enacuavlab/boards/Tawaki/hardware/Outils Montage/test_ gabarit.SLDASM

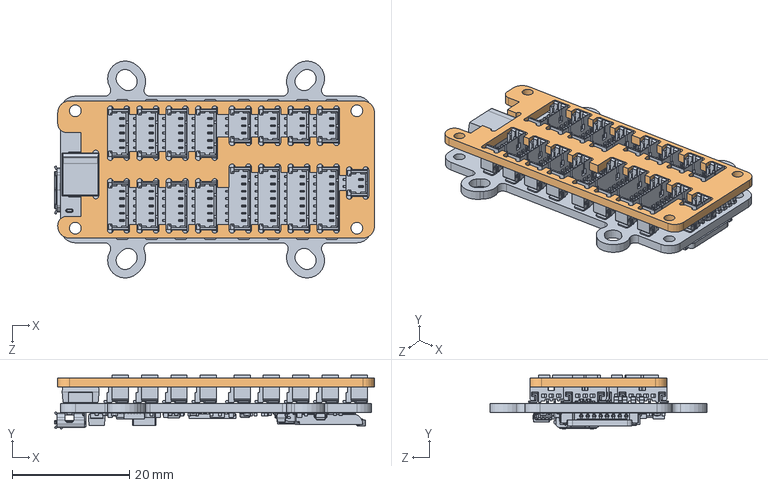
[picture p2: CAD file, 2021-02-25]
Tawaki/hardware/Outils Montage/test_ gabarit.SLDASM
54.5 x 9.16 x 37.0 mm
Tawaki_v100
gabarit_soudage_molex_v0
