enacuavlab/boards/Tawaki/hardware/Outils Montage/fab/gabarit_soudage_molex_v0.DXF

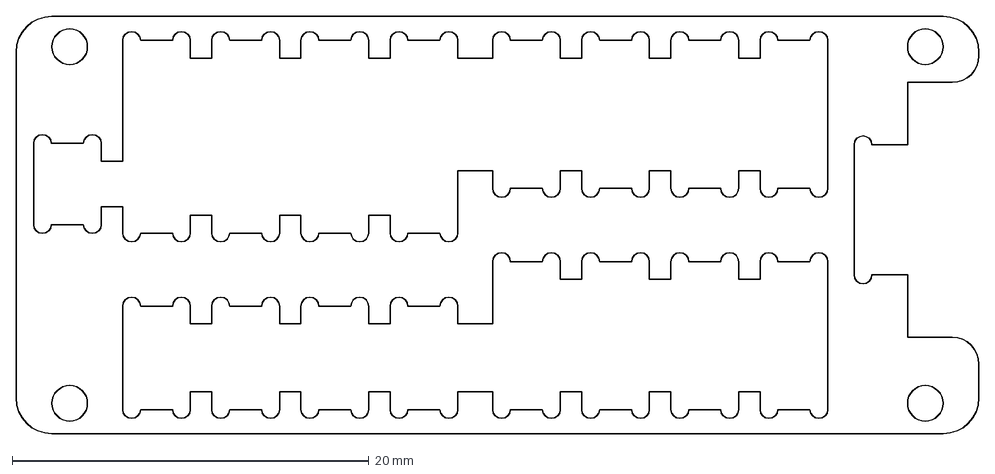
[picture p3: CAD file, 2021-02-25]
Tawaki/hardware/Outils Montage/fab/gabarit_soudage_molex_v0.DXF
54.0 x 23.4 mm
