enacuavlab/boards/Tawaki/hardware/Outils Montage/gabarit_soudage_molex_v0.SLDPRT

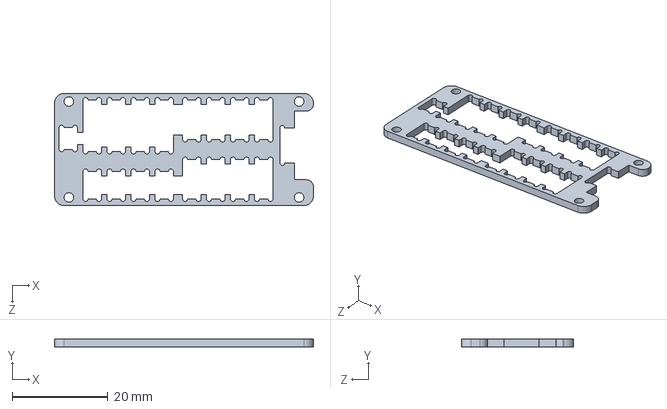
[picture p4: CAD file, 2021-02-25]
Tawaki/hardware/Outils Montage/gabarit_soudage_molex_v0.SLDPRT
54.0 x 1.60 x 23.4 mm
