enacuavlab/boards/Tawaki/hardware/Tawaki_v110_implantation bottom.pdf

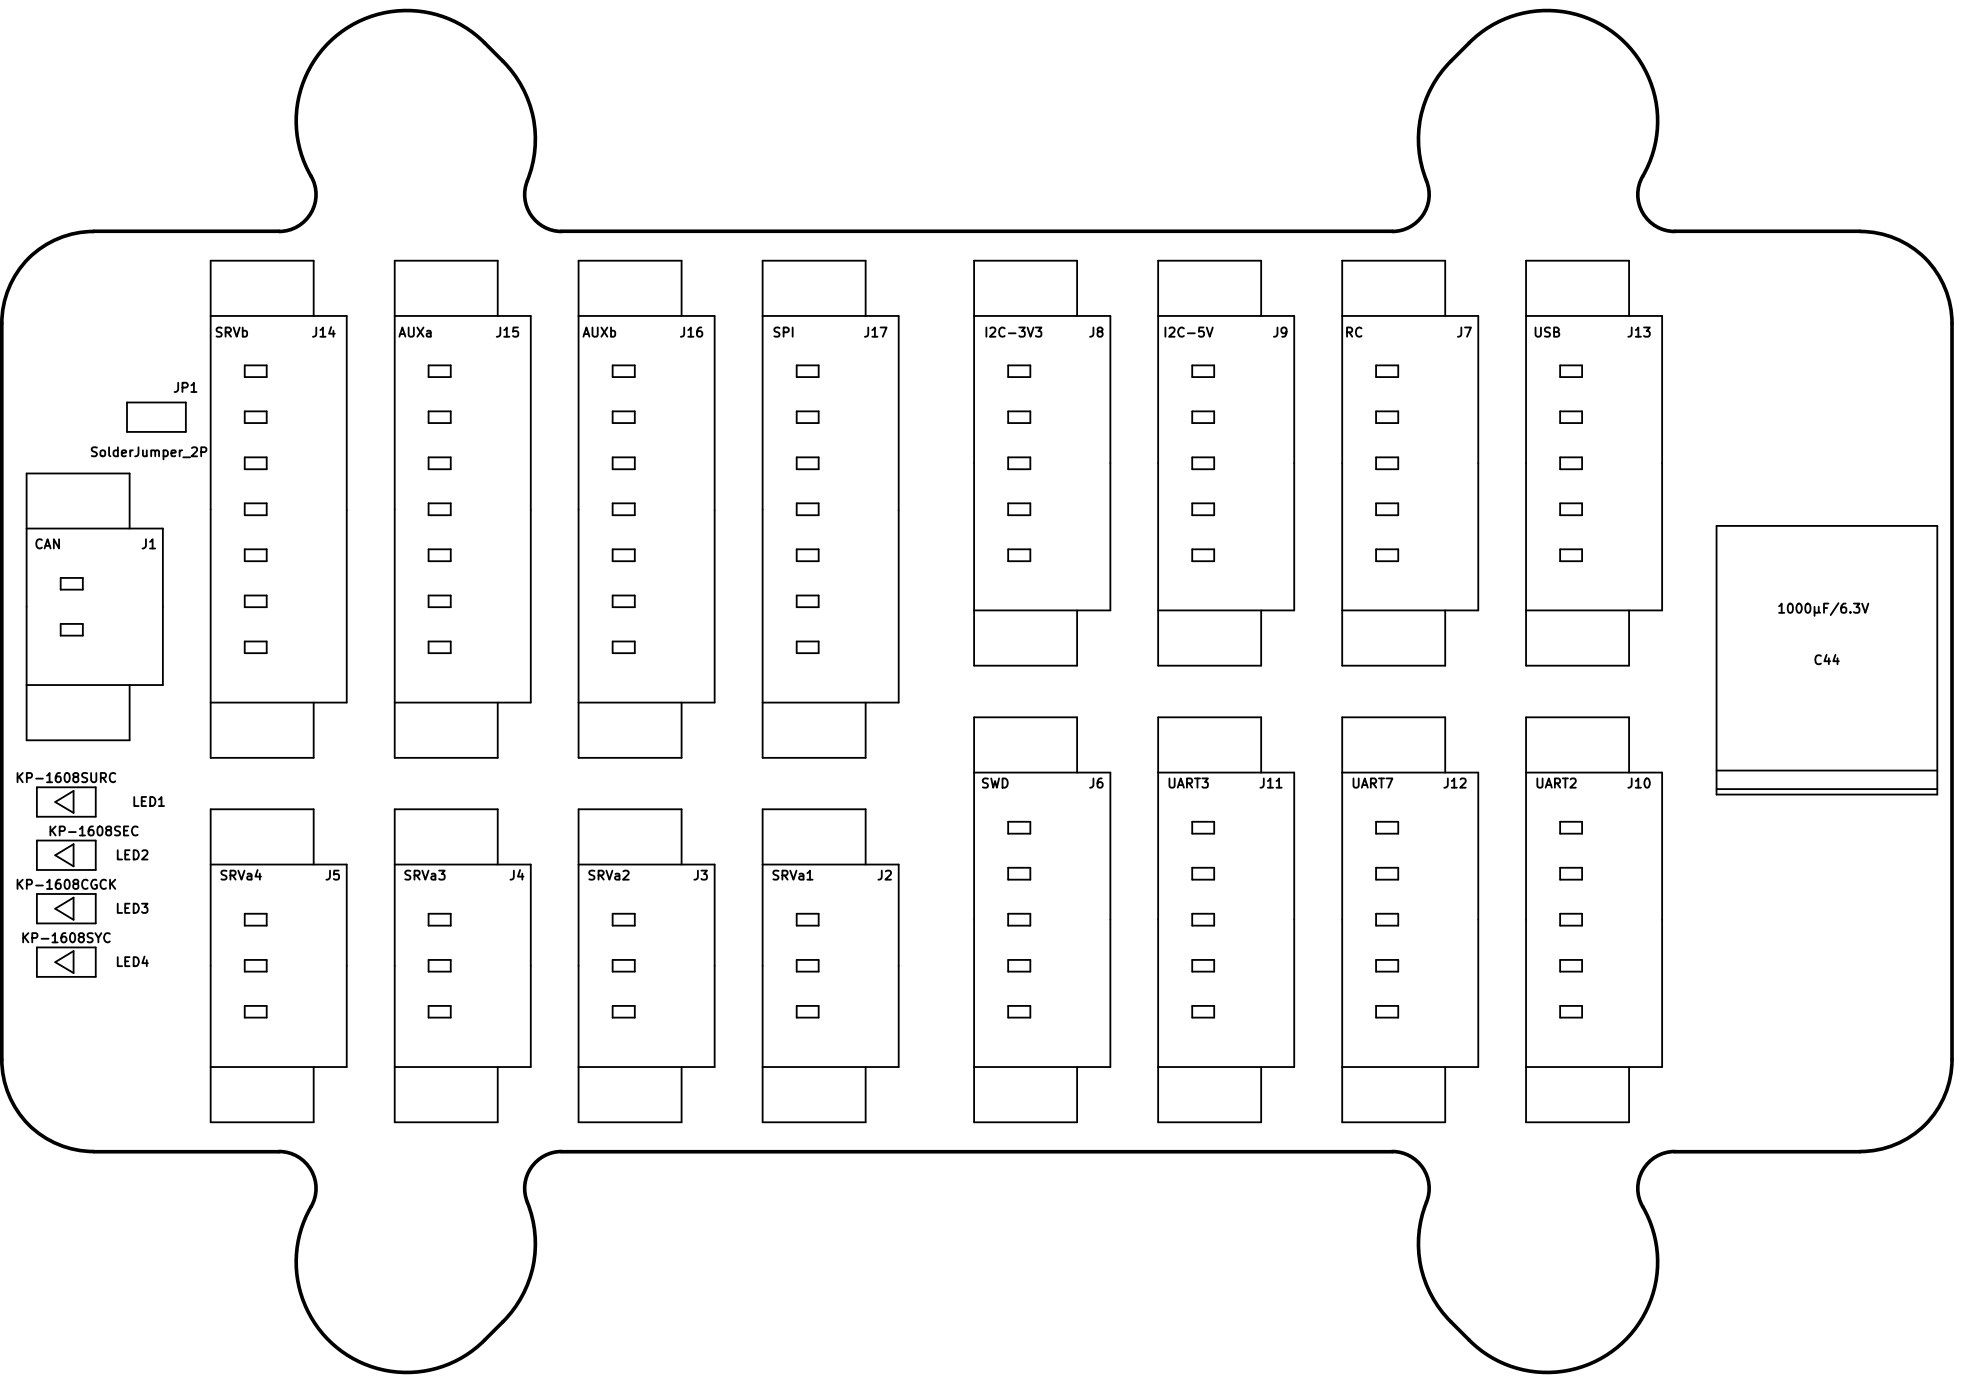
[picture p5: page 1]
