enacuavlab/boards/Tawaki/hardware/Tawaki_v110.kicad_pcb

## KiCad design Tawaki/hardware/Tawaki_v110.kicad_pcb (2021-02-25)

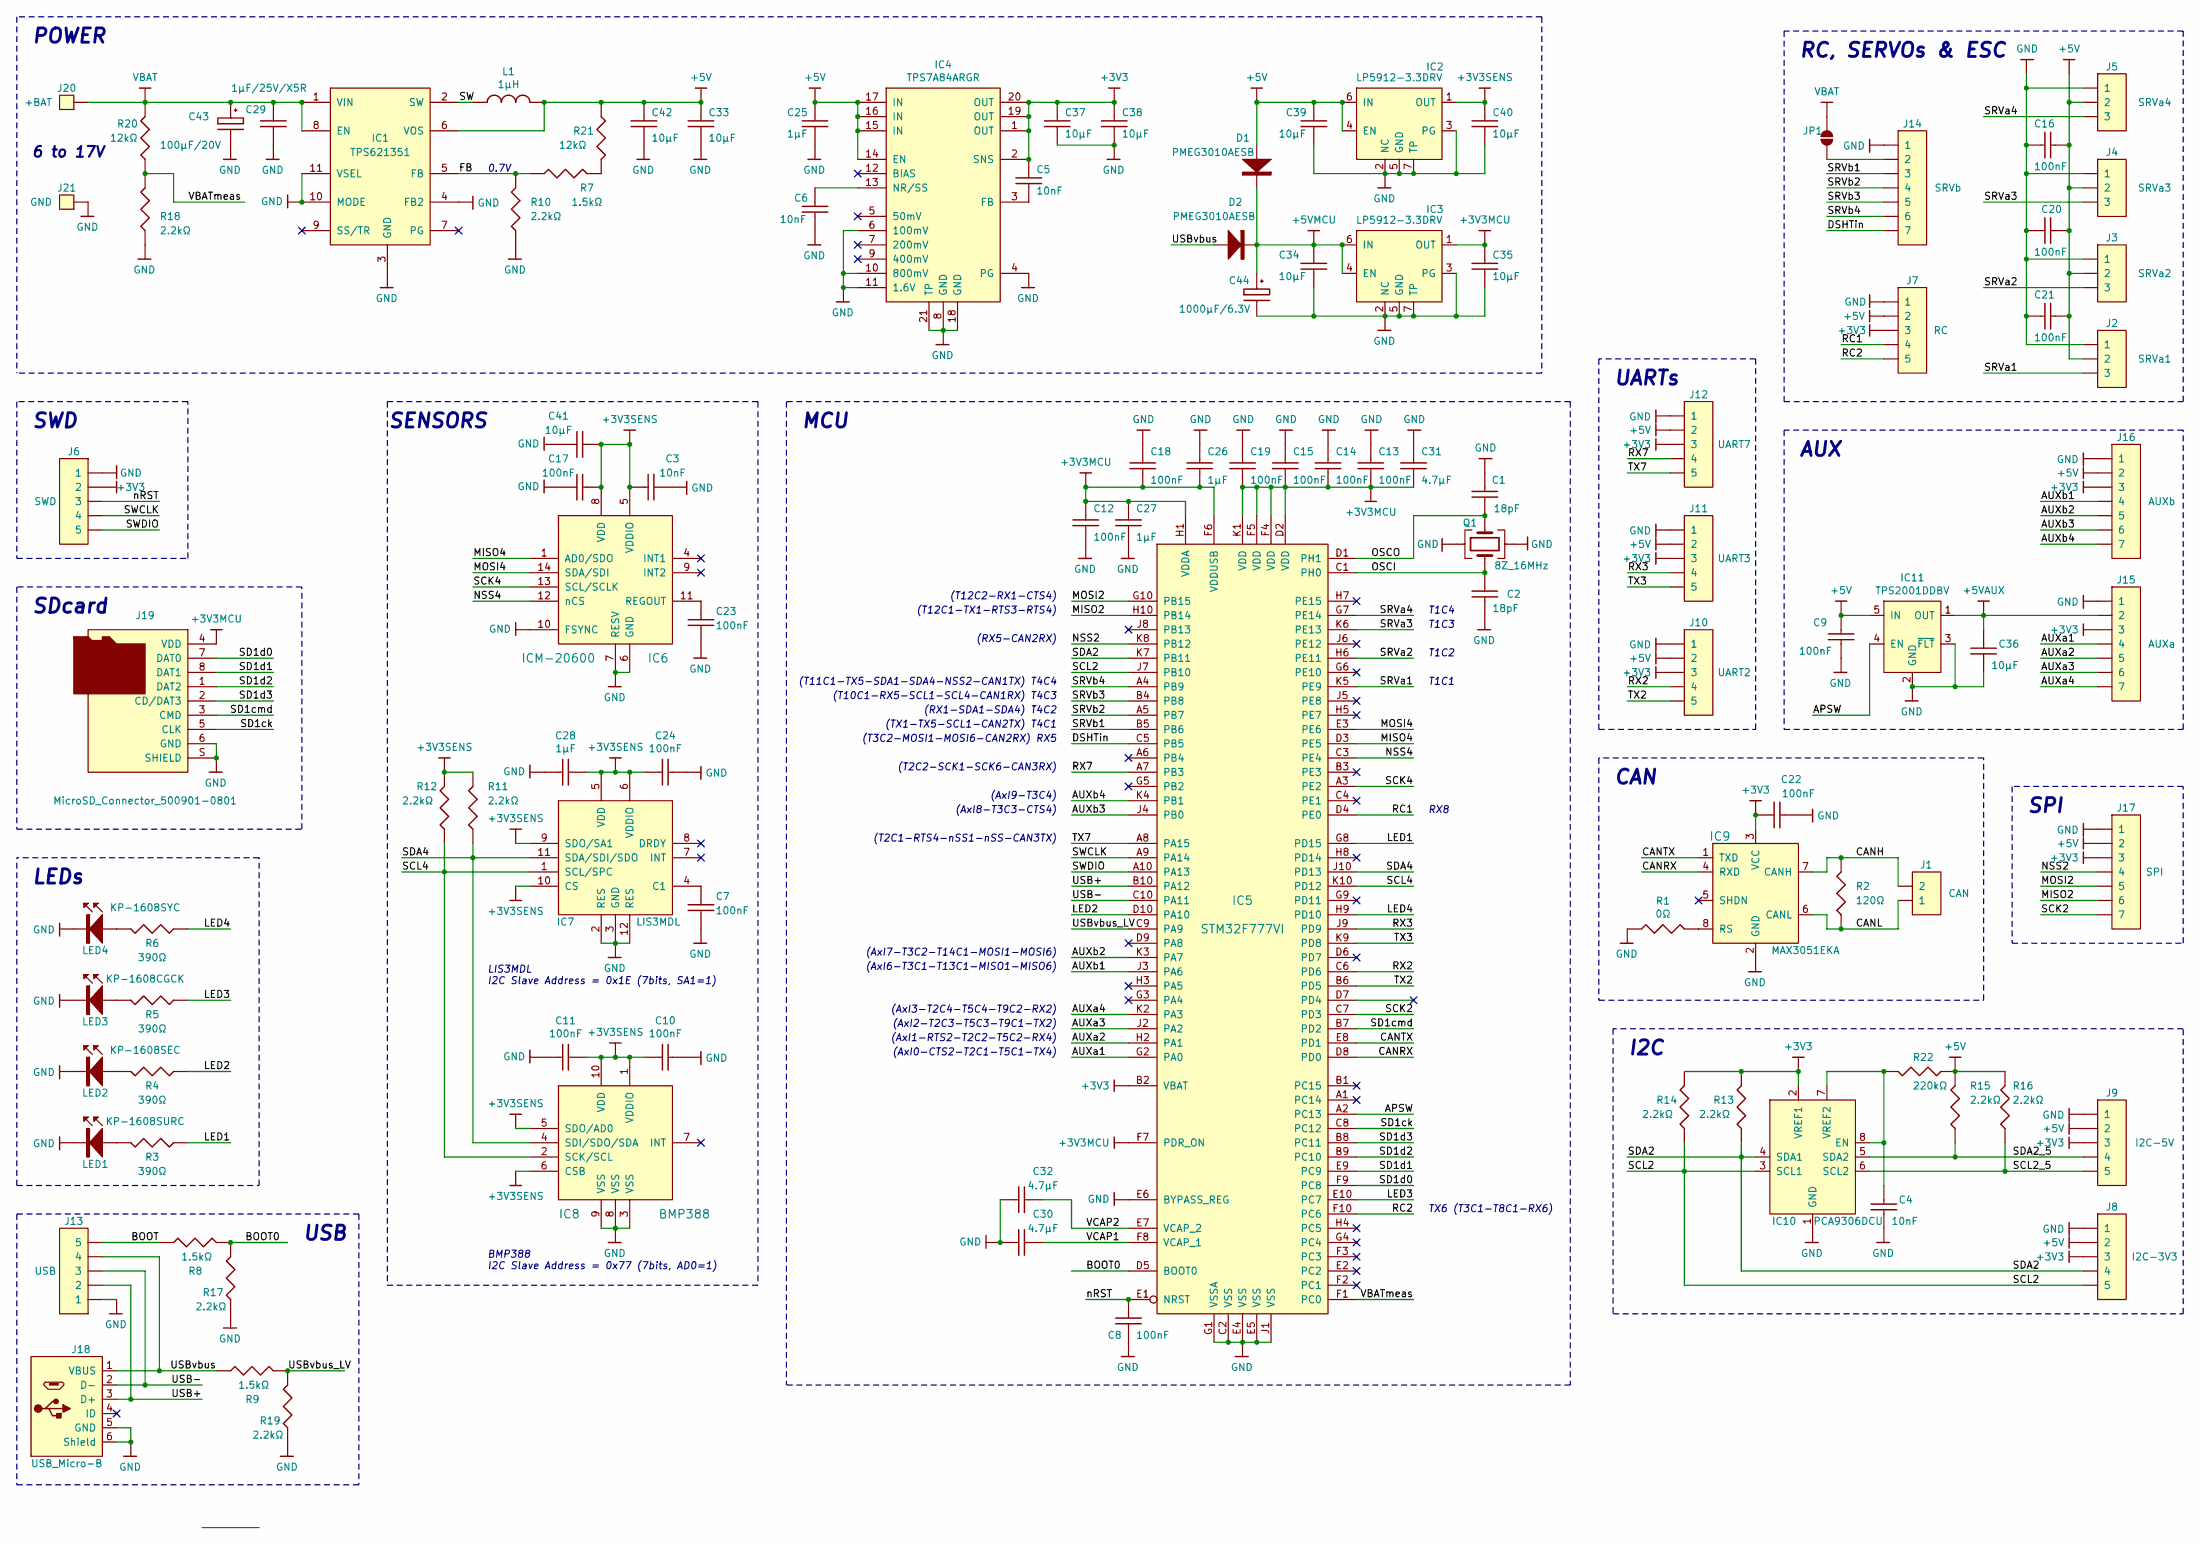
[picture p6: schematic Tawaki_v110.sch, Tawaki Autopilot v1.10]

Parts:
C1, C2: 18pF; C_0402
C3, C4, C5, C6: 10nF; C_0402
C7, C8, C9, C10, C11, C12, C13, C14, C15, C16, C17, C18, C19, C20, C21, C22, C23, C24: 100nF; C_0402
C25, C26, C27, C28: 1µF; C_0402
C29: 1µF/25V/X5R; C_0603
C30, C31, C32: 4.7µF; C_0402
C33, C34, C35, C36, C37, C38, C39, C40, C41, C42: 10µF; C_0603
C43: 100µF/20V; EIA_7343-31
C44: 1000µF/6.3V; EIA_7360-38
D1, D2: PMEG3010AESB
IC1: TPS621351
IC2, IC3: LP5912-3.3DRV; LP5912DRV
IC4: TPS7A84ARGR
IC5: STM32F777VI
IC6: ICM-20600
IC7: LIS3MDL
IC8: BMP388
IC9: MAX3051EKA
IC10: PCA9306DCU
IC11: TPS2001DDBV
J1: CAN; PicoBlade_53398-0271
J2: SRVa1; PicoBlade_53398-0371
J3: SRVa2; PicoBlade_53398-0371
J4: SRVa3; PicoBlade_53398-0371
J5: SRVa4; PicoBlade_53398-0371
J6: SWD; PicoBlade_53398-0571
J7: RC; PicoBlade_53398-0571
J8: I2C-3V3; PicoBlade_53398-0571
J9: I2C-5V; PicoBlade_53398-0571
J10: UART2; PicoBlade_53398-0571
J11: UART3; PicoBlade_53398-0571
J12: UART7; PicoBlade_53398-0571
J13: USB; PicoBlade_53398-0571
J14: SRVb; PicoBlade_53398-0771
J15: AUXa; PicoBlade_53398-0771
J16: AUXb; PicoBlade_53398-0771
J17: SPI; PicoBlade_53398-0771
J18: USB_Micro-B; USB_Micro-B_Molex_105017-0001
J19: MicroSD_Connector_500901-0801; MicroSD_500901-0801
J20: +BAT; SquareWirePad_SMD_2x4mm
J21: GND; SquareWirePad_SMD_2x4mm
JP1: SolderJumper_2P; SolderJumper_2P_TrianglePads_0603
L1: 1µH; XFL4020
LED1: KP-1608SURC
LED2: KP-1608SEC
LED3: KP-1608CGCK
LED4: KP-1608SYC
Q1: 8Z_16MHz; Crystal_8Z
R1: 0Ω; R_0402
R2: 120Ω; R_0402
R3, R4, R5, R6: 390Ω; R_0402
R7, R8, R9: 1.5kΩ; R_0402
R10, R11, R12, R13, R14, R15, R16, R17, R18, R19: 2.2kΩ; R_0402
R20, R21: 12kΩ; R_0402
R22: 220kΩ; R_0402

Connections:
+3V3: C5.1, C22.2, C37.1, C38.1, IC4.1 (OUT), IC4.2 (SNS), IC4.19 (OUT), IC4.20 (OUT), IC5.B2 (VBAT), IC9.3 (VCC), IC10.2 (VREF1), J6.2, J7.3, J8.3, J9.3, J10.3, J11.3, J12.3, J15.3, J16.3, J17.3, R13.1, R14.1
+3V3MCU: C12.1, C13.2, C14.2, C15.2, C18.2, C19.2, C26.2, C27.1, C31.2, C35.1, IC3.1 (OUT), IC5.D2 (VDD), IC5.F4 (VDD), IC5.F5 (VDD), IC5.F6 (VDDUSB), IC5.F7 (PDR_ON), IC5.H1 (VDDA), IC5.K1 (VDD), J19.4 (VDD)
+3V3SENS: C3.2, C10.2, C11.1, C17.1, C24.2, C28.1, C40.1, C41.1, IC2.1 (OUT), IC6.5 (VDDIO), IC6.8 (VDD), IC7.5 (VDD), IC7.6 (VDDIO), IC7.9 (SDO/SA1), IC7.10 (CS), IC8.1 (VDDIO), IC8.5 (SDO/AD0), IC8.6 (CSB), IC8.10 (VDD), R11.1, R12.1
+5V: C9.1, C16.1, C20.1, C21.1, C25.1, C33.1, C39.1, C42.1, D1.2 (A), IC1.6 (VOS), IC2.4 (EN), IC2.6 (IN), IC4.14 (EN), IC4.15 (IN), IC4.16 (IN), IC4.17 (IN), IC11.5 (IN), J2.2, J3.2, J4.2, J5.2, J7.2, J8.2, J9.2, J10.2, J11.2, J12.2, J16.2, J17.2, L1.2, R15.1, R16.1, R21.2, R22.1
+5VAUX: C36.1, IC11.1 (OUT), J15.2
+5VMCU: C34.1, C44.1, D1.1 (K), D2.1 (K), IC3.4 (EN), IC3.6 (IN)
/APSW: IC5.A2 (PC13), IC11.4 (EN)
/AUXa1: IC5.G2 (PA0), J15.4
/AUXa2: IC5.H2 (PA1), J15.5
/AUXa3: IC5.J2 (PA2), J15.6
/AUXa4: IC5.K2 (PA3), J15.7
/AUXb1: IC5.J3 (PA6), J16.4
/AUXb2: IC5.K3 (PA7), J16.5
/AUXb3: IC5.J4 (PB0), J16.6
/AUXb4: IC5.K4 (PB1), J16.7
/BOOT: J13.5, R8.2
/BOOT0: IC5.D5 (BOOT0), R8.1, R17.1
/CANH: IC9.7 (CANH), J1.2, R2.1
/CANL: IC9.6 (CANL), J1.1, R2.2
/CANRX: IC5.D8 (PD0), IC9.4 (RXD)
/CANTX: IC5.E8 (PD1), IC9.1 (TXD)
/DSHTin: IC5.C5 (PB5), J14.7
/FB: IC1.5 (FB), R7.2, R10.1
/LED1: IC5.G8 (PD15), R3.1
/LED2: IC5.D10 (PA10), R4.1
/LED3: IC5.E10 (PC7), R5.1
/LED4: IC5.H9 (PD10), R6.1
/MISO2: IC5.H10 (PB14), J17.6
/MISO4: IC5.D3 (PE5), IC6.1 (AD0/SDO)
/MOSI2: IC5.G10 (PB15), J17.5
/MOSI4: IC5.E3 (PE6), IC6.14 (SDA/SDI)
/NSS2: IC5.K8 (PB12), J17.4
/NSS4: IC5.C3 (PE4), IC6.12 (nCS)
/OSCI: C2.2, IC5.C1 (PH0), Q1.3
/OSCO: C1.2, IC5.D1 (PH1), Q1.1
/RC1: IC5.D4 (PE0), J7.4
/RC2: IC5.F10 (PC6), J7.5
/RX2: IC5.C6 (PD6), J10.4
/RX3: IC5.J9 (PD9), J11.4
/RX7: IC5.A7 (PB3), J12.4
/SCK2: IC5.C7 (PD3), J17.7
/SCK4: IC5.A3 (PE2), IC6.13 (SCL/SCLK)
/SCL2: IC5.J7 (PB10), IC10.3 (SCL1), J8.5, R14.2
/SCL2_5: IC10.6 (SCL2), J9.5, R16.2
/SCL4: IC5.K10 (PD12), IC7.1 (SCL/SPC), IC8.2 (SCK/SCL), R12.2
/SD1ck: IC5.C8 (PC12), J19.5 (CLK)
/SD1cmd: IC5.B7 (PD2), J19.3 (CMD)
/SD1d0: IC5.F9 (PC8), J19.7 (DAT0)
/SD1d1: IC5.E9 (PC9), J19.8 (DAT1)
/SD1d2: IC5.B9 (PC10), J19.1 (DAT2)
/SD1d3: IC5.B8 (PC11), J19.2 (CD/DAT3)
/SDA2: IC5.K7 (PB11), IC10.4 (SDA1), J8.4, R13.2
/SDA2_5: IC10.5 (SDA2), J9.4, R15.2
/SDA4: IC5.J10 (PD13), IC7.11 (SDA/SDI/SDO), IC8.4 (SDI/SDO/SDA), R11.2
/SRVa1: IC5.K5 (PE9), J2.3
/SRVa2: IC5.H6 (PE11), J3.3
/SRVa3: IC5.K6 (PE13), J4.3
/SRVa4: IC5.G7 (PE14), J5.3
/SRVb1: IC5.B5 (PB6), J14.3
/SRVb2: IC5.A5 (PB7), J14.4
/SRVb3: IC5.B4 (PB8), J14.5
/SRVb4: IC5.A4 (PB9), J14.6
/SW: IC1.2 (SW), L1.1
/SWCLK: IC5.A9 (PA14), J6.4
/SWDIO: IC5.A10 (PA13), J6.5
/TX2: IC5.B6 (PD5), J10.5
/TX3: IC5.K9 (PD8), J11.5
/TX7: IC5.A8 (PA15), J12.5
/USB+: IC5.B10 (PA12), J13.2, J18.3 (D+)
/USB-: IC5.C10 (PA11), J13.3, J18.2 (D-)
/USBvbus: D2.2 (A), J13.4, J18.1 (VBUS), R9.2
/USBvbus_LV: IC5.C9 (PA9), R9.1, R19.1
/VBATmeas: IC5.F1 (PC0), R18.1, R20.2
/VCAP1: C30.1, IC5.F8 (VCAP_1)
/VCAP2: C32.1, IC5.E7 (VCAP_2)
/nRST: C8.1, IC5.E1 (NRST), J6.3
GND: C1.1, C2.1, C3.1, C4.2, C6.2, C7.2, C8.2, C9.2, C10.1, C11.2, C12.2, C13.1, C14.1, C15.1, C16.2, C17.2, C18.1, C19.1, C20.2, C21.2, C22.1, C23.2, C24.1, C25.2, C26.1, C27.2, C28.2, C29.2, C30.2, C31.1, C32.2, C33.2, C34.2, C35.2, C36.2, C37.2, C38.2, C39.2, C40.2, C41.2, C42.2, C43.2, C44.2, IC1.3 (GND), IC1.4 (FB2), IC1.10 (MODE), IC1.11 (VSEL), IC2.2 (NC), IC2.3 (PG), IC2.5 (GND), IC2.7 (TP), IC3.2 (NC), IC3.3 (PG), IC3.5 (GND), IC3.7 (TP), IC4.4 (PG), IC4.6 (100mV), IC4.8 (GND), IC4.10 (800mV), IC4.11 (1.6V), IC4.18 (GND), IC4.21 (TP), IC5.C2 (VSS), IC5.E4 (VSS), IC5.E5 (VSS), IC5.E6 (BYPASS_REG), IC5.G1 (VSSA), IC5.J1 (VSS), IC6.6 (GND), IC6.7 (RESV), IC6.10 (FSYNC), IC7.2 (RES), IC7.3 (GND), IC7.12 (RES), IC8.3 (VSS), IC8.8 (VSS), IC8.9 (VSS), IC9.2 (GND), IC10.1 (GND), IC11.2 (GND), IC11.3 (~FLT), J2.1, J3.1, J4.1, J5.1, J6.1, J7.1, J8.1, J9.1, J10.1, J11.1, J12.1, J13.1, J14.1, J15.1, J16.1, J17.1, J18.5 (GND), J18.6 (Shield), J19.6 (GND), J19.S (SHIELD), J21.1, LED1.1 (K), LED2.1 (K), LED3.1 (K), LED4.1 (K), Q1.2, Q1.4, R1.2, R10.2, R17.2, R18.2, R19.2
unnamed: C4.1, IC10.7 (VREF2), IC10.8 (EN), R22.2
unnamed: C5.2, IC4.3 (FB)
unnamed: C6.1, IC4.13 (NR/SS)
unnamed: C7.1, IC7.4 (C1)
unnamed: C23.1, IC6.11 (REGOUT)
unnamed: IC9.8 (RS), R1.1
unnamed: J14.2, JP1.2 (B)
unnamed: LED1.2 (A), R3.2
unnamed: LED2.2 (A), R4.2
unnamed: LED3.2 (A), R5.2
unnamed: LED4.2 (A), R6.2
unnamed: R7.1, R21.1
VBAT: C29.1, C43.1, IC1.1 (VIN), IC1.8 (EN), J20.1, JP1.1 (A), R20.1

Notes on the sheet:
0.7V
6 to 17V
I2C
CAN
RC, SERVOs & ESC
MCU
UARTs
SPI
USB
AUX
SENSORS
LIS3MDL I2C Slave Address = 0x1E (7bits, SA1=1)
BMP388 I2C Slave Address = 0x77 (7bits, AD0=1)
POWER
RX8
TX6 (T3C1-T8C1-RX6)
(AxI0-CTS2-T2C1-T5C1-TX4)
(AxI1-RTS2-T2C2-T5C2-RX4)
(AxI6-T3C1-T13C1-MISO1-MISO6)
(AxI2-T2C3-T5C3-T9C1-TX2)
(AxI3-T2C4-T5C4-T9C2-RX2)
(AxI7-T3C2-T14C1-MOSI1-MOSI6)
(AxI8-T3C3-CTS4)
(AxI9-T3C4)
T1C1
T1C2
T1C3
T1C4
(TX1-TX5-SCL1-CAN2TX) T4C1
(RX1-SDA1-SDA4) T4C2
(T10C1-RX5-SCL1-SCL4-CAN1RX) T4C3
(T11C1-TX5-SDA1-SDA4-NSS2-CAN1TX) T4C4
(T3C2-MOSI1-MOSI6-CAN2RX) RX5
(T12C2-RX1-CTS4)
(T12C1-TX1-RTS3-RTS4)
(T2C2-SCK1-SCK6-CAN3RX)
(T2C1-RTS4-nSS1-nSS-CAN3TX)
(RX5-CAN2RX)
SDcard
LEDs
SWD

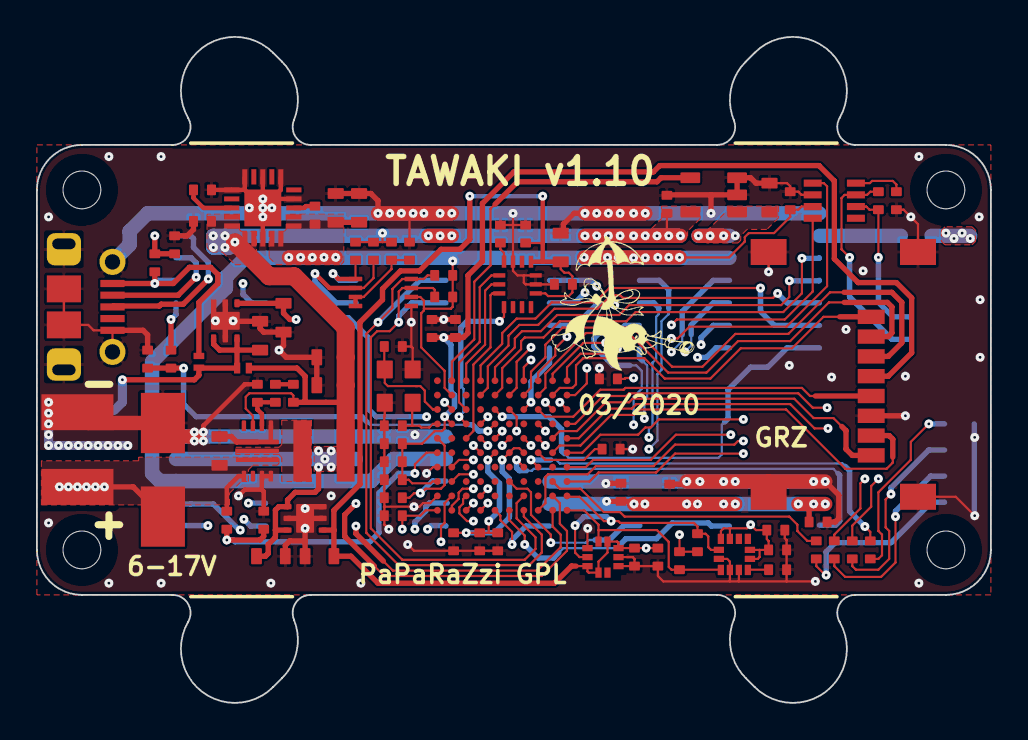
[picture p7: board Tawaki_v110.kicad_pcb from above]

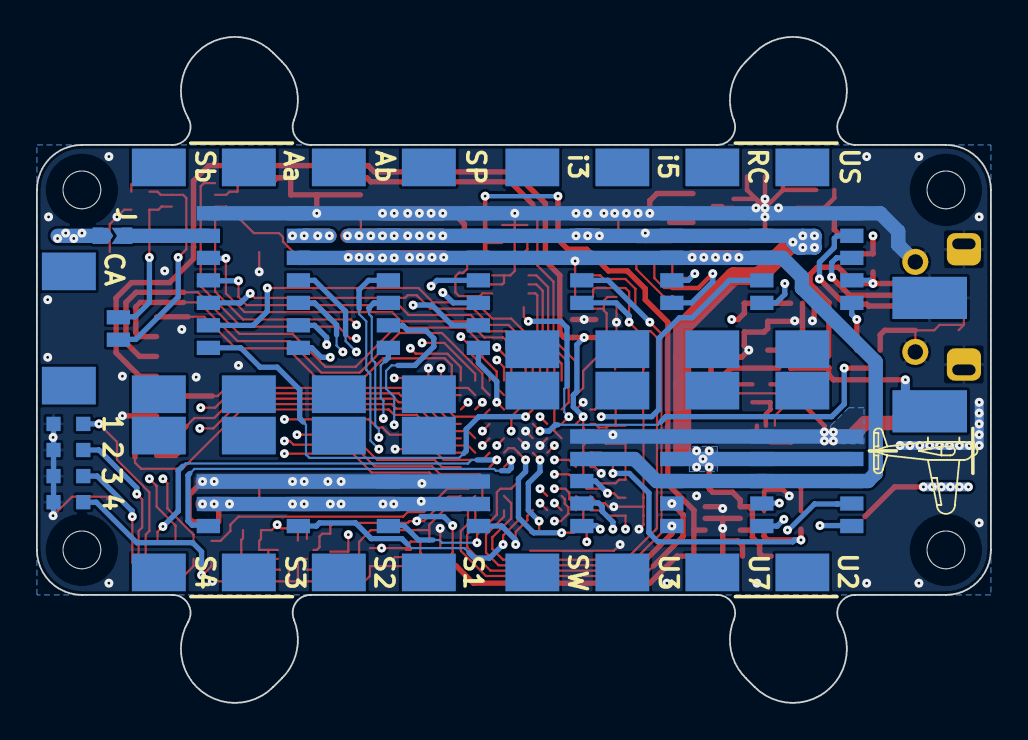
[picture p8: board Tawaki_v110.kicad_pcb from below]

Board: 4 copper layers, 53.0 x 37.0 mm, 107 parts (23 on the bottom side), 90 nets.
