enacuavlab/boards/Chimera/chibios/cfg/board.h

/*
    ChibiOS - Copyright (C) 2006..2015 Giovanni Di Sirio

    Licensed under the Apache License, Version 2.0 (the "License");
    you may not use this file except in compliance with the License.
    You may obtain a copy of the License at

        http://www.apache.org/licenses/LICENSE-2.0

    Unless required by applicable law or agreed to in writing, software
    distributed under the License is distributed on an "AS IS" BASIS,
    WITHOUT WARRANTIES OR CONDITIONS OF ANY KIND, either express or implied.
    See the License for the specific language governing permissions and
    limitations under the License.
*/

#pragma once

/*
 * Board identifier.
 */
#define BOARD_CHIMERA
#define BOARD_NAME                  "Chimera Autopilot"

/*
 * Board oscillators-related settings.
 */
#if !defined(STM32_LSECLK)
#define STM32_LSECLK                32768U
#endif

#define STM32_LSEDRV                (3U << 3U)

#if !defined(STM32_HSECLK)
#define STM32_HSECLK                16000000U
#endif

/*
 * Board voltages.
 * Required for performance limits calculation.
 */
#define STM32_VDD                   300U

/*
 * MCU type as defined in the ST header.
 */
#define STM32F767xx

/*
 * IO pins assignments.
 */
#define	PA00_AUX3                      0U
#define	PA01_RC1_UART4_RX              1U
#define	PA02_AUX2                      2U
#define	PA03_AUX1                      3U
#define	PA04_VBAT_MEAS                 4U
#define	PA05_AUX0                      5U
#define	PA06_SRV0_TIM3_CH1             6U
#define	PA07_SRV1_TIM3_CH2             7U
#define	PA08_XB_ASSO                   8U
#define	PA09_USB_VBUS                  9U
#define	PA10_SD_DETECT                 10U
#define	PA11_OTG_FS_DM                 11U
#define	PA12_OTG_FS_DP                 12U
#define	PA13_SWDIO                     13U
#define	PA14_SWCLK                     14U
#define	PA15_SPI1_CS                   15U

#define	PB00_SRV2_TIM3_CH3             0U
#define	PB01_SRV3_TIM3_CH4             1U
#define	PB02_RC1                       2U
#define	PB03_SPI1_SCK                  3U
#define	PB04_SPI1_MISO                 4U
#define	PB05_SPI1_MOSI                 5U
#define	PB06_USART1_TX                 6U
#define	PB07_USART1_RX                 7U
#define	PB08_I2C1_SCL                  8U
#define	PB09_I2C1_SDA                  9U
#define	PB10_I2C2_SCL                  10U
#define	PB11_I2C2_SDA                  11U
#define	PB12_LED1                      12U
#define	PB13_LED2                      13U
#define	PB14_DIS_C                     14U
#define	PB15_DIS_DP                    15U

#define	PC00                           0U
#define	PC01                           1U
#define	PC02_AUX5                      2U
#define	PC03_AUX4                      3U
#define	PC04_EN_COMP                   4U
#define	PC05                           5U
#define	PC06_AUX6                      6U
#define	PC07_AUX7                      7U
#define	PC08_SDMMC1_D0                 8U
#define	PC09_SDMMC1_D1                 9U
#define	PC10_SDMMC1_D2                 10U
#define	PC11_SDMMC1_D3                 11U
#define	PC12_SDMMC1_CK                 12U
#define	PC13                           13U
#define	PC14_OSC32_IN                  14U
#define	PC15_OSC32_OUT                 15U

#define	PD00_CAN1_RX                   0U
#define	PD01_CAN1_TX                   1U
#define	PD02_SDMMC1_CMD                2U
#define	PD03_USART2_CTS                3U
#define	PD04_USART2_RTS                4U
#define	PD05_USART2_TX                 5U
#define	PD06_USART2_RX                 6U
#define	PD07_IMU_INT                   7U
#define	PD08_USART3_TX                 8U
#define	PD09_USART3_RX                 9U
#define	PD10_LED3                      10U
#define	PD11_LED4                      11U
#define	PD12_SRV4_TIM4_CH1             12U
#define	PD13_SRV5_TIM4_CH2             13U
#define	PD14_SRV6_TIM4_CH3             14U
#define	PD15_SRV7_TIM4_CH4             15U

#define	PE00_UART8_RX                  0U
#define	PE01_UART8_TX                  1U
#define	PE02_DIS_G                     2U
#define	PE03_DIS_F                     3U
#define	PE04_DIS_A                     4U
#define	PE05_DIS_B                     5U
#define	PE06_APSW                      6U
#define	PE07_RC2_UART7_RX              7U
#define	PE08_DIS_E                     8U
#define	PE09_DIS_D                     9U
#define	PE10                           10U
#define	PE11                           11U
#define	PE12                           12U
#define	PE13                           13U
#define	PE14                           14U
#define	PE15_XB_RST                    15U

#define	PF00                           0U
#define	PF01                           1U
#define	PF02                           2U
#define	PF03                           3U
#define	PF04                           4U
#define	PF05                           5U
#define	PF06                           6U
#define	PF07                           7U
#define	PF08                           8U
#define	PF09                           9U
#define	PF10                           10U
#define	PF11                           11U
#define	PF12                           12U
#define	PF13                           13U
#define	PF14                           14U
#define	PF15                           15U

#define	PG00                           0U
#define	PG01                           1U
#define	PG02                           2U
#define	PG03                           3U
#define	PG04                           4U
#define	PG05                           5U
#define	PG06                           6U
#define	PG07                           7U
#define	PG08                           8U
#define	PG09                           9U
#define	PG10                           10U
#define	PG11                           11U
#define	PG12                           12U
#define	PG13                           13U
#define	PG14                           14U
#define	PG15                           15U

#define	PH00_OSC_IN                    0U
#define	PH01_OSC_OUT                   1U
#define	PH02                           2U
#define	PH03                           3U
#define	PH04                           4U
#define	PH05                           5U
#define	PH06                           6U
#define	PH07                           7U
#define	PH08                           8U
#define	PH09                           9U
#define	PH10                           10U
#define	PH11                           11U
#define	PH12                           12U
#define	PH13                           13U
#define	PH14                           14U
#define	PH15                           15U

#define	PI00                           0U
#define	PI01                           1U
#define	PI02                           2U
#define	PI03                           3U
#define	PI04                           4U
#define	PI05                           5U
#define	PI06                           6U
#define	PI07                           7U
#define	PI08                           8U
#define	PI09                           9U
#define	PI10                           10U
#define	PI11                           11U
#define	PI12                           12U
#define	PI13                           13U
#define	PI14                           14U
#define	PI15                           15U

#define	PJ00                           0U
#define	PJ01                           1U
#define	PJ02                           2U
#define	PJ03                           3U
#define	PJ04                           4U
#define	PJ05                           5U
#define	PJ06                           6U
#define	PJ07                           7U
#define	PJ08                           8U
#define	PJ09                           9U
#define	PJ10                           10U
#define	PJ11                           11U
#define	PJ12                           12U
#define	PJ13                           13U
#define	PJ14                           14U
#define	PJ15                           15U

#define	PK00                           0U
#define	PK01                           1U
#define	PK02                           2U
#define	PK03                           3U
#define	PK04                           4U
#define	PK05                           5U
#define	PK06                           6U
#define	PK07                           7U
#define	PK08                           8U
#define	PK09                           9U
#define	PK10                           10U
#define	PK11                           11U
#define	PK12                           12U
#define	PK13                           13U
#define	PK14                           14U
#define	PK15                           15U

/*
 * IO lines assignments.
 */
#define	LINE_AUX3                      PAL_LINE(GPIOA, 0U)
#define	LINE_RC1_UART4_RX              PAL_LINE(GPIOA, 1U)
#define	LINE_AUX2                      PAL_LINE(GPIOA, 2U)
#define	LINE_AUX1                      PAL_LINE(GPIOA, 3U)
#define	LINE_VBAT_MEAS                 PAL_LINE(GPIOA, 4U)
#define	LINE_AUX0                      PAL_LINE(GPIOA, 5U)
#define	LINE_SRV0_TIM3_CH1             PAL_LINE(GPIOA, 6U)
#define	LINE_SRV1_TIM3_CH2             PAL_LINE(GPIOA, 7U)
#define	LINE_XB_ASSO                   PAL_LINE(GPIOA, 8U)
#define	LINE_USB_VBUS                  PAL_LINE(GPIOA, 9U)
#define	LINE_SD_DETECT                 PAL_LINE(GPIOA, 10U)
#define	LINE_OTG_FS_DM                 PAL_LINE(GPIOA, 11U)
#define	LINE_OTG_FS_DP                 PAL_LINE(GPIOA, 12U)
#define	LINE_SWDIO                     PAL_LINE(GPIOA, 13U)
#define	LINE_SWCLK                     PAL_LINE(GPIOA, 14U)
#define	LINE_SPI1_CS                   PAL_LINE(GPIOA, 15U)

#define	LINE_SRV2_TIM3_CH3             PAL_LINE(GPIOB, 0U)
#define	LINE_SRV3_TIM3_CH4             PAL_LINE(GPIOB, 1U)
#define	LINE_RC1                       PAL_LINE(GPIOB, 2U)
#define	LINE_SPI1_SCK                  PAL_LINE(GPIOB, 3U)
#define	LINE_SPI1_MISO                 PAL_LINE(GPIOB, 4U)
#define	LINE_SPI1_MOSI                 PAL_LINE(GPIOB, 5U)
#define	LINE_USART1_TX                 PAL_LINE(GPIOB, 6U)
#define	LINE_USART1_RX                 PAL_LINE(GPIOB, 7U)
#define	LINE_I2C1_SCL                  PAL_LINE(GPIOB, 8U)
#define	LINE_I2C1_SDA                  PAL_LINE(GPIOB, 9U)
#define	LINE_I2C2_SCL                  PAL_LINE(GPIOB, 10U)
#define	LINE_I2C2_SDA                  PAL_LINE(GPIOB, 11U)
#define	LINE_LED1                      PAL_LINE(GPIOB, 12U)
#define	LINE_LED2                      PAL_LINE(GPIOB, 13U)
#define	LINE_DIS_C                     PAL_LINE(GPIOB, 14U)
#define	LINE_DIS_DP                    PAL_LINE(GPIOB, 15U)

#define	LINE_AUX5                      PAL_LINE(GPIOC, 2U)
#define	LINE_AUX4                      PAL_LINE(GPIOC, 3U)
#define	LINE_EN_COMP                   PAL_LINE(GPIOC, 4U)
#define	LINE_AUX6                      PAL_LINE(GPIOC, 6U)
#define	LINE_AUX7                      PAL_LINE(GPIOC, 7U)
#define	LINE_SDMMC1_D0                 PAL_LINE(GPIOC, 8U)
#define	LINE_SDMMC1_D1                 PAL_LINE(GPIOC, 9U)
#define	LINE_SDMMC1_D2                 PAL_LINE(GPIOC, 10U)
#define	LINE_SDMMC1_D3                 PAL_LINE(GPIOC, 11U)
#define	LINE_SDMMC1_CK                 PAL_LINE(GPIOC, 12U)
#define	LINE_OSC32_IN                  PAL_LINE(GPIOC, 14U)
#define	LINE_OSC32_OUT                 PAL_LINE(GPIOC, 15U)

#define	LINE_CAN1_RX                   PAL_LINE(GPIOD, 0U)
#define	LINE_CAN1_TX                   PAL_LINE(GPIOD, 1U)
#define	LINE_SDMMC1_CMD                PAL_LINE(GPIOD, 2U)
#define	LINE_USART2_CTS                PAL_LINE(GPIOD, 3U)
#define	LINE_USART2_RTS                PAL_LINE(GPIOD, 4U)
#define	LINE_USART2_TX                 PAL_LINE(GPIOD, 5U)
#define	LINE_USART2_RX                 PAL_LINE(GPIOD, 6U)
#define	LINE_IMU_INT                   PAL_LINE(GPIOD, 7U)
#define	LINE_USART3_TX                 PAL_LINE(GPIOD, 8U)
#define	LINE_USART3_RX                 PAL_LINE(GPIOD, 9U)
#define	LINE_LED3                      PAL_LINE(GPIOD, 10U)
#define	LINE_LED4                      PAL_LINE(GPIOD, 11U)
#define	LINE_SRV4_TIM4_CH1             PAL_LINE(GPIOD, 12U)
#define	LINE_SRV5_TIM4_CH2             PAL_LINE(GPIOD, 13U)
#define	LINE_SRV6_TIM4_CH3             PAL_LINE(GPIOD, 14U)
#define	LINE_SRV7_TIM4_CH4             PAL_LINE(GPIOD, 15U)

#define	LINE_UART8_RX                  PAL_LINE(GPIOE, 0U)
#define	LINE_UART8_TX                  PAL_LINE(GPIOE, 1U)
#define	LINE_DIS_G                     PAL_LINE(GPIOE, 2U)
#define	LINE_DIS_F                     PAL_LINE(GPIOE, 3U)
#define	LINE_DIS_A                     PAL_LINE(GPIOE, 4U)
#define	LINE_DIS_B                     PAL_LINE(GPIOE, 5U)
#define	LINE_APSW                      PAL_LINE(GPIOE, 6U)
#define	LINE_RC2_UART7_RX              PAL_LINE(GPIOE, 7U)
#define	LINE_DIS_E                     PAL_LINE(GPIOE, 8U)
#define	LINE_DIS_D                     PAL_LINE(GPIOE, 9U)
#define	LINE_XB_RST                    PAL_LINE(GPIOE, 15U)

#define	LINE_OSC_IN                    PAL_LINE(GPIOH, 0U)
#define	LINE_OSC_OUT                   PAL_LINE(GPIOH, 1U)


/*
 * I/O ports initial setup, this configuration is established soon after reset
 * in the initialization code.
 * Please refer to the STM32 Reference Manual for details.
 */
#define PIN_MODE_INPUT(n)           (0U << ((n) * 2U))
#define PIN_MODE_OUTPUT(n)          (1U << ((n) * 2U))
#define PIN_MODE_ALTERNATE(n)       (2U << ((n) * 2U))
#define PIN_MODE_ANALOG(n)          (3U << ((n) * 2U))
#define PIN_ODR_LEVEL_LOW(n)        (0U << (n))
#define PIN_ODR_LEVEL_HIGH(n)       (1U << (n))
#define PIN_OTYPE_PUSHPULL(n)       (0U << (n))
#define PIN_OTYPE_OPENDRAIN(n)      (1U << (n))
#define PIN_OSPEED_SPEED_VERYLOW(n) (0U << ((n) * 2U))
#define PIN_OSPEED_SPEED_LOW(n)     (1U << ((n) * 2U))
#define PIN_OSPEED_SPEED_MEDIUM(n)  (2U << ((n) * 2U))
#define PIN_OSPEED_SPEED_HIGH(n)    (3U << ((n) * 2U))
#define PIN_PUPDR_FLOATING(n)       (0U << ((n) * 2U))
#define PIN_PUPDR_PULLUP(n)         (1U << ((n) * 2U))
#define PIN_PUPDR_PULLDOWN(n)       (2U << ((n) * 2U))
#define PIN_AFIO_AF(n, v)           ((v) << (((n) % 8U) * 4U))

#define VAL_GPIOA_MODER                 (PIN_MODE_INPUT(PA00_AUX3) | \
					 PIN_MODE_ALTERNATE(PA01_RC1_UART4_RX) | \
					 PIN_MODE_INPUT(PA02_AUX2) | \
					 PIN_MODE_INPUT(PA03_AUX1) | \
					 PIN_MODE_ANALOG(PA04_VBAT_MEAS) | \
					 PIN_MODE_ANALOG(PA05_AUX0) | \
					 PIN_MODE_ALTERNATE(PA06_SRV0_TIM3_CH1) | \
					 PIN_MODE_ALTERNATE(PA07_SRV1_TIM3_CH2) | \
					 PIN_MODE_INPUT(PA08_XB_ASSO) | \
					 PIN_MODE_INPUT(PA09_USB_VBUS) | \
					 PIN_MODE_INPUT(PA10_SD_DETECT) | \
					 PIN_MODE_ALTERNATE(PA11_OTG_FS_DM) | \
					 PIN_MODE_ALTERNATE(PA12_OTG_FS_DP) | \
					 PIN_MODE_ALTERNATE(PA13_SWDIO) | \
					 PIN_MODE_ALTERNATE(PA14_SWCLK) | \
					 PIN_MODE_OUTPUT(PA15_SPI1_CS))

#define VAL_GPIOA_OTYPER                (PIN_OTYPE_OPENDRAIN(PA00_AUX3) | \
					 PIN_OTYPE_PUSHPULL(PA01_RC1_UART4_RX) | \
					 PIN_OTYPE_OPENDRAIN(PA02_AUX2) | \
					 PIN_OTYPE_OPENDRAIN(PA03_AUX1) | \
					 PIN_OTYPE_PUSHPULL(PA04_VBAT_MEAS) | \
					 PIN_OTYPE_PUSHPULL(PA05_AUX0) | \
					 PIN_OTYPE_PUSHPULL(PA06_SRV0_TIM3_CH1) | \
					 PIN_OTYPE_PUSHPULL(PA07_SRV1_TIM3_CH2) | \
					 PIN_OTYPE_OPENDRAIN(PA08_XB_ASSO) | \
					 PIN_OTYPE_OPENDRAIN(PA09_USB_VBUS) | \
					 PIN_OTYPE_OPENDRAIN(PA10_SD_DETECT) | \
					 PIN_OTYPE_PUSHPULL(PA11_OTG_FS_DM) | \
					 PIN_OTYPE_PUSHPULL(PA12_OTG_FS_DP) | \
					 PIN_OTYPE_PUSHPULL(PA13_SWDIO) | \
					 PIN_OTYPE_PUSHPULL(PA14_SWCLK) | \
					 PIN_OTYPE_PUSHPULL(PA15_SPI1_CS))

#define VAL_GPIOA_OSPEEDR               (PIN_OSPEED_SPEED_VERYLOW(PA00_AUX3) | \
					 PIN_OSPEED_SPEED_HIGH(PA01_RC1_UART4_RX) | \
					 PIN_OSPEED_SPEED_VERYLOW(PA02_AUX2) | \
					 PIN_OSPEED_SPEED_VERYLOW(PA03_AUX1) | \
					 PIN_OSPEED_SPEED_VERYLOW(PA04_VBAT_MEAS) | \
					 PIN_OSPEED_SPEED_VERYLOW(PA05_AUX0) | \
					 PIN_OSPEED_SPEED_HIGH(PA06_SRV0_TIM3_CH1) | \
					 PIN_OSPEED_SPEED_HIGH(PA07_SRV1_TIM3_CH2) | \
					 PIN_OSPEED_SPEED_VERYLOW(PA08_XB_ASSO) | \
					 PIN_OSPEED_SPEED_VERYLOW(PA09_USB_VBUS) | \
					 PIN_OSPEED_SPEED_VERYLOW(PA10_SD_DETECT) | \
					 PIN_OSPEED_SPEED_HIGH(PA11_OTG_FS_DM) | \
					 PIN_OSPEED_SPEED_HIGH(PA12_OTG_FS_DP) | \
					 PIN_OSPEED_SPEED_HIGH(PA13_SWDIO) | \
					 PIN_OSPEED_SPEED_HIGH(PA14_SWCLK) | \
					 PIN_OSPEED_SPEED_HIGH(PA15_SPI1_CS))

#define VAL_GPIOA_PUPDR                 (PIN_PUPDR_PULLDOWN(PA00_AUX3) | \
					 PIN_PUPDR_FLOATING(PA01_RC1_UART4_RX) | \
					 PIN_PUPDR_PULLDOWN(PA02_AUX2) | \
					 PIN_PUPDR_PULLDOWN(PA03_AUX1) | \
					 PIN_PUPDR_FLOATING(PA04_VBAT_MEAS) | \
					 PIN_PUPDR_FLOATING(PA05_AUX0) | \
					 PIN_PUPDR_FLOATING(PA06_SRV0_TIM3_CH1) | \
					 PIN_PUPDR_FLOATING(PA07_SRV1_TIM3_CH2) | \
					 PIN_PUPDR_FLOATING(PA08_XB_ASSO) | \
					 PIN_PUPDR_PULLDOWN(PA09_USB_VBUS) | \
					 PIN_PUPDR_PULLUP(PA10_SD_DETECT) | \
					 PIN_PUPDR_FLOATING(PA11_OTG_FS_DM) | \
					 PIN_PUPDR_FLOATING(PA12_OTG_FS_DP) | \
					 PIN_PUPDR_FLOATING(PA13_SWDIO) | \
					 PIN_PUPDR_FLOATING(PA14_SWCLK) | \
					 PIN_PUPDR_FLOATING(PA15_SPI1_CS))

#define VAL_GPIOA_ODR                   (PIN_ODR_LEVEL_HIGH(PA00_AUX3) | \
					 PIN_ODR_LEVEL_HIGH(PA01_RC1_UART4_RX) | \
					 PIN_ODR_LEVEL_HIGH(PA02_AUX2) | \
					 PIN_ODR_LEVEL_HIGH(PA03_AUX1) | \
					 PIN_ODR_LEVEL_LOW(PA04_VBAT_MEAS) | \
					 PIN_ODR_LEVEL_LOW(PA05_AUX0) | \
					 PIN_ODR_LEVEL_LOW(PA06_SRV0_TIM3_CH1) | \
					 PIN_ODR_LEVEL_LOW(PA07_SRV1_TIM3_CH2) | \
					 PIN_ODR_LEVEL_LOW(PA08_XB_ASSO) | \
					 PIN_ODR_LEVEL_LOW(PA09_USB_VBUS) | \
					 PIN_ODR_LEVEL_LOW(PA10_SD_DETECT) | \
					 PIN_ODR_LEVEL_HIGH(PA11_OTG_FS_DM) | \
					 PIN_ODR_LEVEL_HIGH(PA12_OTG_FS_DP) | \
					 PIN_ODR_LEVEL_HIGH(PA13_SWDIO) | \
					 PIN_ODR_LEVEL_HIGH(PA14_SWCLK) | \
					 PIN_ODR_LEVEL_HIGH(PA15_SPI1_CS))

#define VAL_GPIOA_AFRL			(PIN_AFIO_AF(PA00_AUX3, 0) | \
					 PIN_AFIO_AF(PA01_RC1_UART4_RX, 8) | \
					 PIN_AFIO_AF(PA02_AUX2, 0) | \
					 PIN_AFIO_AF(PA03_AUX1, 0) | \
					 PIN_AFIO_AF(PA04_VBAT_MEAS, 0) | \
					 PIN_AFIO_AF(PA05_AUX0, 0) | \
					 PIN_AFIO_AF(PA06_SRV0_TIM3_CH1, 2) | \
					 PIN_AFIO_AF(PA07_SRV1_TIM3_CH2, 2))

#define VAL_GPIOA_AFRH			(PIN_AFIO_AF(PA08_XB_ASSO, 0) | \
					 PIN_AFIO_AF(PA09_USB_VBUS, 0) | \
					 PIN_AFIO_AF(PA10_SD_DETECT, 0) | \
					 PIN_AFIO_AF(PA11_OTG_FS_DM, 10) | \
					 PIN_AFIO_AF(PA12_OTG_FS_DP, 10) | \
					 PIN_AFIO_AF(PA13_SWDIO, 0) | \
					 PIN_AFIO_AF(PA14_SWCLK, 0) | \
					 PIN_AFIO_AF(PA15_SPI1_CS, 0))

#define VAL_GPIOB_MODER                 (PIN_MODE_ALTERNATE(PB00_SRV2_TIM3_CH3) | \
					 PIN_MODE_ALTERNATE(PB01_SRV3_TIM3_CH4) | \
					 PIN_MODE_INPUT(PB02_RC1) | \
					 PIN_MODE_ALTERNATE(PB03_SPI1_SCK) | \
					 PIN_MODE_ALTERNATE(PB04_SPI1_MISO) | \
					 PIN_MODE_ALTERNATE(PB05_SPI1_MOSI) | \
					 PIN_MODE_ALTERNATE(PB06_USART1_TX) | \
					 PIN_MODE_ALTERNATE(PB07_USART1_RX) | \
					 PIN_MODE_ALTERNATE(PB08_I2C1_SCL) | \
					 PIN_MODE_ALTERNATE(PB09_I2C1_SDA) | \
					 PIN_MODE_ALTERNATE(PB10_I2C2_SCL) | \
					 PIN_MODE_ALTERNATE(PB11_I2C2_SDA) | \
					 PIN_MODE_OUTPUT(PB12_LED1) | \
					 PIN_MODE_OUTPUT(PB13_LED2) | \
					 PIN_MODE_OUTPUT(PB14_DIS_C) | \
					 PIN_MODE_OUTPUT(PB15_DIS_DP))

#define VAL_GPIOB_OTYPER                (PIN_OTYPE_PUSHPULL(PB00_SRV2_TIM3_CH3) | \
					 PIN_OTYPE_PUSHPULL(PB01_SRV3_TIM3_CH4) | \
					 PIN_OTYPE_OPENDRAIN(PB02_RC1) | \
					 PIN_OTYPE_PUSHPULL(PB03_SPI1_SCK) | \
					 PIN_OTYPE_PUSHPULL(PB04_SPI1_MISO) | \
					 PIN_OTYPE_PUSHPULL(PB05_SPI1_MOSI) | \
					 PIN_OTYPE_PUSHPULL(PB06_USART1_TX) | \
					 PIN_OTYPE_PUSHPULL(PB07_USART1_RX) | \
					 PIN_OTYPE_OPENDRAIN(PB08_I2C1_SCL) | \
					 PIN_OTYPE_OPENDRAIN(PB09_I2C1_SDA) | \
					 PIN_OTYPE_OPENDRAIN(PB10_I2C2_SCL) | \
					 PIN_OTYPE_OPENDRAIN(PB11_I2C2_SDA) | \
					 PIN_OTYPE_PUSHPULL(PB12_LED1) | \
					 PIN_OTYPE_PUSHPULL(PB13_LED2) | \
					 PIN_OTYPE_PUSHPULL(PB14_DIS_C) | \
					 PIN_OTYPE_PUSHPULL(PB15_DIS_DP))

#define VAL_GPIOB_OSPEEDR               (PIN_OSPEED_SPEED_HIGH(PB00_SRV2_TIM3_CH3) | \
					 PIN_OSPEED_SPEED_HIGH(PB01_SRV3_TIM3_CH4) | \
					 PIN_OSPEED_SPEED_VERYLOW(PB02_RC1) | \
					 PIN_OSPEED_SPEED_HIGH(PB03_SPI1_SCK) | \
					 PIN_OSPEED_SPEED_HIGH(PB04_SPI1_MISO) | \
					 PIN_OSPEED_SPEED_HIGH(PB05_SPI1_MOSI) | \
					 PIN_OSPEED_SPEED_HIGH(PB06_USART1_TX) | \
					 PIN_OSPEED_SPEED_HIGH(PB07_USART1_RX) | \
					 PIN_OSPEED_SPEED_HIGH(PB08_I2C1_SCL) | \
					 PIN_OSPEED_SPEED_HIGH(PB09_I2C1_SDA) | \
					 PIN_OSPEED_SPEED_HIGH(PB10_I2C2_SCL) | \
					 PIN_OSPEED_SPEED_HIGH(PB11_I2C2_SDA) | \
					 PIN_OSPEED_SPEED_VERYLOW(PB12_LED1) | \
					 PIN_OSPEED_SPEED_VERYLOW(PB13_LED2) | \
					 PIN_OSPEED_SPEED_VERYLOW(PB14_DIS_C) | \
					 PIN_OSPEED_SPEED_VERYLOW(PB15_DIS_DP))

#define VAL_GPIOB_PUPDR                 (PIN_PUPDR_FLOATING(PB00_SRV2_TIM3_CH3) | \
					 PIN_PUPDR_FLOATING(PB01_SRV3_TIM3_CH4) | \
					 PIN_PUPDR_FLOATING(PB02_RC1) | \
					 PIN_PUPDR_FLOATING(PB03_SPI1_SCK) | \
					 PIN_PUPDR_FLOATING(PB04_SPI1_MISO) | \
					 PIN_PUPDR_FLOATING(PB05_SPI1_MOSI) | \
					 PIN_PUPDR_FLOATING(PB06_USART1_TX) | \
					 PIN_PUPDR_FLOATING(PB07_USART1_RX) | \
					 PIN_PUPDR_PULLUP(PB08_I2C1_SCL) | \
					 PIN_PUPDR_PULLUP(PB09_I2C1_SDA) | \
					 PIN_PUPDR_PULLUP(PB10_I2C2_SCL) | \
					 PIN_PUPDR_PULLUP(PB11_I2C2_SDA) | \
					 PIN_PUPDR_FLOATING(PB12_LED1) | \
					 PIN_PUPDR_FLOATING(PB13_LED2) | \
					 PIN_PUPDR_FLOATING(PB14_DIS_C) | \
					 PIN_PUPDR_FLOATING(PB15_DIS_DP))

#define VAL_GPIOB_ODR                   (PIN_ODR_LEVEL_LOW(PB00_SRV2_TIM3_CH3) | \
					 PIN_ODR_LEVEL_LOW(PB01_SRV3_TIM3_CH4) | \
					 PIN_ODR_LEVEL_LOW(PB02_RC1) | \
					 PIN_ODR_LEVEL_HIGH(PB03_SPI1_SCK) | \
					 PIN_ODR_LEVEL_HIGH(PB04_SPI1_MISO) | \
					 PIN_ODR_LEVEL_HIGH(PB05_SPI1_MOSI) | \
					 PIN_ODR_LEVEL_HIGH(PB06_USART1_TX) | \
					 PIN_ODR_LEVEL_HIGH(PB07_USART1_RX) | \
					 PIN_ODR_LEVEL_HIGH(PB08_I2C1_SCL) | \
					 PIN_ODR_LEVEL_HIGH(PB09_I2C1_SDA) | \
					 PIN_ODR_LEVEL_HIGH(PB10_I2C2_SCL) | \
					 PIN_ODR_LEVEL_HIGH(PB11_I2C2_SDA) | \
					 PIN_ODR_LEVEL_LOW(PB12_LED1) | \
					 PIN_ODR_LEVEL_LOW(PB13_LED2) | \
					 PIN_ODR_LEVEL_LOW(PB14_DIS_C) | \
					 PIN_ODR_LEVEL_LOW(PB15_DIS_DP))

#define VAL_GPIOB_AFRL			(PIN_AFIO_AF(PB00_SRV2_TIM3_CH3, 2) | \
					 PIN_AFIO_AF(PB01_SRV3_TIM3_CH4, 2) | \
					 PIN_AFIO_AF(PB02_RC1, 0) | \
					 PIN_AFIO_AF(PB03_SPI1_SCK, 5) | \
					 PIN_AFIO_AF(PB04_SPI1_MISO, 5) | \
					 PIN_AFIO_AF(PB05_SPI1_MOSI, 5) | \
					 PIN_AFIO_AF(PB06_USART1_TX, 7) | \
					 PIN_AFIO_AF(PB07_USART1_RX, 7))

#define VAL_GPIOB_AFRH			(PIN_AFIO_AF(PB08_I2C1_SCL, 4) | \
					 PIN_AFIO_AF(PB09_I2C1_SDA, 4) | \
					 PIN_AFIO_AF(PB10_I2C2_SCL, 4) | \
					 PIN_AFIO_AF(PB11_I2C2_SDA, 4) | \
					 PIN_AFIO_AF(PB12_LED1, 0) | \
					 PIN_AFIO_AF(PB13_LED2, 0) | \
					 PIN_AFIO_AF(PB14_DIS_C, 0) | \
					 PIN_AFIO_AF(PB15_DIS_DP, 0))

#define VAL_GPIOC_MODER                 (PIN_MODE_INPUT(PC00) | \
					 PIN_MODE_INPUT(PC01) | \
					 PIN_MODE_INPUT(PC02_AUX5) | \
					 PIN_MODE_INPUT(PC03_AUX4) | \
					 PIN_MODE_OUTPUT(PC04_EN_COMP) | \
					 PIN_MODE_INPUT(PC05) | \
					 PIN_MODE_INPUT(PC06_AUX6) | \
					 PIN_MODE_INPUT(PC07_AUX7) | \
					 PIN_MODE_ALTERNATE(PC08_SDMMC1_D0) | \
					 PIN_MODE_ALTERNATE(PC09_SDMMC1_D1) | \
					 PIN_MODE_ALTERNATE(PC10_SDMMC1_D2) | \
					 PIN_MODE_ALTERNATE(PC11_SDMMC1_D3) | \
					 PIN_MODE_ALTERNATE(PC12_SDMMC1_CK) | \
					 PIN_MODE_INPUT(PC13) | \
					 PIN_MODE_INPUT(PC14_OSC32_IN) | \
					 PIN_MODE_INPUT(PC15_OSC32_OUT))

#define VAL_GPIOC_OTYPER                (PIN_OTYPE_PUSHPULL(PC00) | \
					 PIN_OTYPE_PUSHPULL(PC01) | \
					 PIN_OTYPE_OPENDRAIN(PC02_AUX5) | \
					 PIN_OTYPE_OPENDRAIN(PC03_AUX4) | \
					 PIN_OTYPE_PUSHPULL(PC04_EN_COMP) | \
					 PIN_OTYPE_PUSHPULL(PC05) | \
					 PIN_OTYPE_OPENDRAIN(PC06_AUX6) | \
					 PIN_OTYPE_OPENDRAIN(PC07_AUX7) | \
					 PIN_OTYPE_PUSHPULL(PC08_SDMMC1_D0) | \
					 PIN_OTYPE_PUSHPULL(PC09_SDMMC1_D1) | \
					 PIN_OTYPE_PUSHPULL(PC10_SDMMC1_D2) | \
					 PIN_OTYPE_PUSHPULL(PC11_SDMMC1_D3) | \
					 PIN_OTYPE_PUSHPULL(PC12_SDMMC1_CK) | \
					 PIN_OTYPE_PUSHPULL(PC13) | \
					 PIN_OTYPE_PUSHPULL(PC14_OSC32_IN) | \
					 PIN_OTYPE_PUSHPULL(PC15_OSC32_OUT))

#define VAL_GPIOC_OSPEEDR               (PIN_OSPEED_SPEED_VERYLOW(PC00) | \
					 PIN_OSPEED_SPEED_VERYLOW(PC01) | \
					 PIN_OSPEED_SPEED_VERYLOW(PC02_AUX5) | \
					 PIN_OSPEED_SPEED_VERYLOW(PC03_AUX4) | \
					 PIN_OSPEED_SPEED_VERYLOW(PC04_EN_COMP) | \
					 PIN_OSPEED_SPEED_VERYLOW(PC05) | \
					 PIN_OSPEED_SPEED_VERYLOW(PC06_AUX6) | \
					 PIN_OSPEED_SPEED_VERYLOW(PC07_AUX7) | \
					 PIN_OSPEED_SPEED_HIGH(PC08_SDMMC1_D0) | \
					 PIN_OSPEED_SPEED_HIGH(PC09_SDMMC1_D1) | \
					 PIN_OSPEED_SPEED_HIGH(PC10_SDMMC1_D2) | \
					 PIN_OSPEED_SPEED_HIGH(PC11_SDMMC1_D3) | \
					 PIN_OSPEED_SPEED_HIGH(PC12_SDMMC1_CK) | \
					 PIN_OSPEED_SPEED_VERYLOW(PC13) | \
					 PIN_OSPEED_SPEED_HIGH(PC14_OSC32_IN) | \
					 PIN_OSPEED_SPEED_HIGH(PC15_OSC32_OUT))

#define VAL_GPIOC_PUPDR                 (PIN_PUPDR_PULLDOWN(PC00) | \
					 PIN_PUPDR_PULLDOWN(PC01) | \
					 PIN_PUPDR_PULLDOWN(PC02_AUX5) | \
					 PIN_PUPDR_PULLDOWN(PC03_AUX4) | \
					 PIN_PUPDR_FLOATING(PC04_EN_COMP) | \
					 PIN_PUPDR_PULLDOWN(PC05) | \
					 PIN_PUPDR_PULLDOWN(PC06_AUX6) | \
					 PIN_PUPDR_PULLDOWN(PC07_AUX7) | \
					 PIN_PUPDR_PULLUP(PC08_SDMMC1_D0) | \
					 PIN_PUPDR_PULLUP(PC09_SDMMC1_D1) | \
					 PIN_PUPDR_PULLUP(PC10_SDMMC1_D2) | \
					 PIN_PUPDR_PULLUP(PC11_SDMMC1_D3) | \
					 PIN_PUPDR_PULLUP(PC12_SDMMC1_CK) | \
					 PIN_PUPDR_PULLDOWN(PC13) | \
					 PIN_PUPDR_FLOATING(PC14_OSC32_IN) | \
					 PIN_PUPDR_FLOATING(PC15_OSC32_OUT))

#define VAL_GPIOC_ODR                   (PIN_ODR_LEVEL_LOW(PC00) | \
					 PIN_ODR_LEVEL_LOW(PC01) | \
					 PIN_ODR_LEVEL_HIGH(PC02_AUX5) | \
					 PIN_ODR_LEVEL_HIGH(PC03_AUX4) | \
					 PIN_ODR_LEVEL_LOW(PC04_EN_COMP) | \
					 PIN_ODR_LEVEL_LOW(PC05) | \
					 PIN_ODR_LEVEL_HIGH(PC06_AUX6) | \
					 PIN_ODR_LEVEL_HIGH(PC07_AUX7) | \
					 PIN_ODR_LEVEL_HIGH(PC08_SDMMC1_D0) | \
					 PIN_ODR_LEVEL_HIGH(PC09_SDMMC1_D1) | \
					 PIN_ODR_LEVEL_HIGH(PC10_SDMMC1_D2) | \
					 PIN_ODR_LEVEL_HIGH(PC11_SDMMC1_D3) | \
					 PIN_ODR_LEVEL_HIGH(PC12_SDMMC1_CK) | \
					 PIN_ODR_LEVEL_LOW(PC13) | \
					 PIN_ODR_LEVEL_HIGH(PC14_OSC32_IN) | \
					 PIN_ODR_LEVEL_HIGH(PC15_OSC32_OUT))

#define VAL_GPIOC_AFRL			(PIN_AFIO_AF(PC00, 0) | \
					 PIN_AFIO_AF(PC01, 0) | \
					 PIN_AFIO_AF(PC02_AUX5, 0) | \
					 PIN_AFIO_AF(PC03_AUX4, 0) | \
					 PIN_AFIO_AF(PC04_EN_COMP, 0) | \
					 PIN_AFIO_AF(PC05, 0) | \
					 PIN_AFIO_AF(PC06_AUX6, 0) | \
					 PIN_AFIO_AF(PC07_AUX7, 0))

#define VAL_GPIOC_AFRH			(PIN_AFIO_AF(PC08_SDMMC1_D0, 12) | \
					 PIN_AFIO_AF(PC09_SDMMC1_D1, 12) | \
					 PIN_AFIO_AF(PC10_SDMMC1_D2, 12) | \
					 PIN_AFIO_AF(PC11_SDMMC1_D3, 12) | \
					 PIN_AFIO_AF(PC12_SDMMC1_CK, 12) | \
					 PIN_AFIO_AF(PC13, 0) | \
					 PIN_AFIO_AF(PC14_OSC32_IN, 0) | \
					 PIN_AFIO_AF(PC15_OSC32_OUT, 0))

#define VAL_GPIOD_MODER                 (PIN_MODE_ALTERNATE(PD00_CAN1_RX) | \
					 PIN_MODE_ALTERNATE(PD01_CAN1_TX) | \
					 PIN_MODE_ALTERNATE(PD02_SDMMC1_CMD) | \
					 PIN_MODE_ALTERNATE(PD03_USART2_CTS) | \
					 PIN_MODE_ALTERNATE(PD04_USART2_RTS) | \
					 PIN_MODE_ALTERNATE(PD05_USART2_TX) | \
					 PIN_MODE_ALTERNATE(PD06_USART2_RX) | \
					 PIN_MODE_INPUT(PD07_IMU_INT) | \
					 PIN_MODE_ALTERNATE(PD08_USART3_TX) | \
					 PIN_MODE_ALTERNATE(PD09_USART3_RX) | \
					 PIN_MODE_OUTPUT(PD10_LED3) | \
					 PIN_MODE_OUTPUT(PD11_LED4) | \
					 PIN_MODE_ALTERNATE(PD12_SRV4_TIM4_CH1) | \
					 PIN_MODE_ALTERNATE(PD13_SRV5_TIM4_CH2) | \
					 PIN_MODE_ALTERNATE(PD14_SRV6_TIM4_CH3) | \
					 PIN_MODE_ALTERNATE(PD15_SRV7_TIM4_CH4))

#define VAL_GPIOD_OTYPER                (PIN_OTYPE_PUSHPULL(PD00_CAN1_RX) | \
					 PIN_OTYPE_PUSHPULL(PD01_CAN1_TX) | \
					 PIN_OTYPE_PUSHPULL(PD02_SDMMC1_CMD) | \
					 PIN_OTYPE_PUSHPULL(PD03_USART2_CTS) | \
					 PIN_OTYPE_PUSHPULL(PD04_USART2_RTS) | \
					 PIN_OTYPE_PUSHPULL(PD05_USART2_TX) | \
					 PIN_OTYPE_PUSHPULL(PD06_USART2_RX) | \
					 PIN_OTYPE_OPENDRAIN(PD07_IMU_INT) | \
					 PIN_OTYPE_PUSHPULL(PD08_USART3_TX) | \
					 PIN_OTYPE_PUSHPULL(PD09_USART3_RX) | \
					 PIN_OTYPE_PUSHPULL(PD10_LED3) | \
					 PIN_OTYPE_PUSHPULL(PD11_LED4) | \
					 PIN_OTYPE_PUSHPULL(PD12_SRV4_TIM4_CH1) | \
					 PIN_OTYPE_PUSHPULL(PD13_SRV5_TIM4_CH2) | \
					 PIN_OTYPE_PUSHPULL(PD14_SRV6_TIM4_CH3) | \
					 PIN_OTYPE_PUSHPULL(PD15_SRV7_TIM4_CH4))

#define VAL_GPIOD_OSPEEDR               (PIN_OSPEED_SPEED_HIGH(PD00_CAN1_RX) | \
					 PIN_OSPEED_SPEED_HIGH(PD01_CAN1_TX) | \
					 PIN_OSPEED_SPEED_HIGH(PD02_SDMMC1_CMD) | \
					 PIN_OSPEED_SPEED_HIGH(PD03_USART2_CTS) | \
					 PIN_OSPEED_SPEED_HIGH(PD04_USART2_RTS) | \
					 PIN_OSPEED_SPEED_HIGH(PD05_USART2_TX) | \
					 PIN_OSPEED_SPEED_HIGH(PD06_USART2_RX) | \
					 PIN_OSPEED_SPEED_VERYLOW(PD07_IMU_INT) | \
					 PIN_OSPEED_SPEED_HIGH(PD08_USART3_TX) | \
					 PIN_OSPEED_SPEED_HIGH(PD09_USART3_RX) | \
					 PIN_OSPEED_SPEED_VERYLOW(PD10_LED3) | \
					 PIN_OSPEED_SPEED_VERYLOW(PD11_LED4) | \
					 PIN_OSPEED_SPEED_HIGH(PD12_SRV4_TIM4_CH1) | \
					 PIN_OSPEED_SPEED_HIGH(PD13_SRV5_TIM4_CH2) | \
					 PIN_OSPEED_SPEED_HIGH(PD14_SRV6_TIM4_CH3) | \
					 PIN_OSPEED_SPEED_HIGH(PD15_SRV7_TIM4_CH4))

#define VAL_GPIOD_PUPDR                 (PIN_PUPDR_FLOATING(PD00_CAN1_RX) | \
					 PIN_PUPDR_FLOATING(PD01_CAN1_TX) | \
					 PIN_PUPDR_PULLUP(PD02_SDMMC1_CMD) | \
					 PIN_PUPDR_FLOATING(PD03_USART2_CTS) | \
					 PIN_PUPDR_FLOATING(PD04_USART2_RTS) | \
					 PIN_PUPDR_FLOATING(PD05_USART2_TX) | \
					 PIN_PUPDR_FLOATING(PD06_USART2_RX) | \
					 PIN_PUPDR_FLOATING(PD07_IMU_INT) | \
					 PIN_PUPDR_FLOATING(PD08_USART3_TX) | \
					 PIN_PUPDR_FLOATING(PD09_USART3_RX) | \
					 PIN_PUPDR_FLOATING(PD10_LED3) | \
					 PIN_PUPDR_FLOATING(PD11_LED4) | \
					 PIN_PUPDR_FLOATING(PD12_SRV4_TIM4_CH1) | \
					 PIN_PUPDR_FLOATING(PD13_SRV5_TIM4_CH2) | \
					 PIN_PUPDR_FLOATING(PD14_SRV6_TIM4_CH3) | \
					 PIN_PUPDR_FLOATING(PD15_SRV7_TIM4_CH4))

#define VAL_GPIOD_ODR                   (PIN_ODR_LEVEL_HIGH(PD00_CAN1_RX) | \
					 PIN_ODR_LEVEL_HIGH(PD01_CAN1_TX) | \
					 PIN_ODR_LEVEL_HIGH(PD02_SDMMC1_CMD) | \
					 PIN_ODR_LEVEL_HIGH(PD03_USART2_CTS) | \
					 PIN_ODR_LEVEL_HIGH(PD04_USART2_RTS) | \
					 PIN_ODR_LEVEL_HIGH(PD05_USART2_TX) | \
					 PIN_ODR_LEVEL_HIGH(PD06_USART2_RX) | \
					 PIN_ODR_LEVEL_LOW(PD07_IMU_INT) | \
					 PIN_ODR_LEVEL_HIGH(PD08_USART3_TX) | \
					 PIN_ODR_LEVEL_HIGH(PD09_USART3_RX) | \
					 PIN_ODR_LEVEL_LOW(PD10_LED3) | \
					 PIN_ODR_LEVEL_LOW(PD11_LED4) | \
					 PIN_ODR_LEVEL_LOW(PD12_SRV4_TIM4_CH1) | \
					 PIN_ODR_LEVEL_LOW(PD13_SRV5_TIM4_CH2) | \
					 PIN_ODR_LEVEL_LOW(PD14_SRV6_TIM4_CH3) | \
					 PIN_ODR_LEVEL_LOW(PD15_SRV7_TIM4_CH4))

#define VAL_GPIOD_AFRL			(PIN_AFIO_AF(PD00_CAN1_RX, 9) | \
					 PIN_AFIO_AF(PD01_CAN1_TX, 9) | \
					 PIN_AFIO_AF(PD02_SDMMC1_CMD, 12) | \
					 PIN_AFIO_AF(PD03_USART2_CTS, 7) | \
					 PIN_AFIO_AF(PD04_USART2_RTS, 7) | \
					 PIN_AFIO_AF(PD05_USART2_TX, 7) | \
					 PIN_AFIO_AF(PD06_USART2_RX, 7) | \
					 PIN_AFIO_AF(PD07_IMU_INT, 0))

#define VAL_GPIOD_AFRH			(PIN_AFIO_AF(PD08_USART3_TX, 7) | \
					 PIN_AFIO_AF(PD09_USART3_RX, 7) | \
					 PIN_AFIO_AF(PD10_LED3, 0) | \
					 PIN_AFIO_AF(PD11_LED4, 0) | \
					 PIN_AFIO_AF(PD12_SRV4_TIM4_CH1, 2) | \
					 PIN_AFIO_AF(PD13_SRV5_TIM4_CH2, 2) | \
					 PIN_AFIO_AF(PD14_SRV6_TIM4_CH3, 2) | \
					 PIN_AFIO_AF(PD15_SRV7_TIM4_CH4, 2))

#define VAL_GPIOE_MODER                 (PIN_MODE_ALTERNATE(PE00_UART8_RX) | \
					 PIN_MODE_ALTERNATE(PE01_UART8_TX) | \
					 PIN_MODE_OUTPUT(PE02_DIS_G) | \
					 PIN_MODE_OUTPUT(PE03_DIS_F) | \
					 PIN_MODE_OUTPUT(PE04_DIS_A) | \
					 PIN_MODE_OUTPUT(PE05_DIS_B) | \
					 PIN_MODE_OUTPUT(PE06_APSW) | \
					 PIN_MODE_ALTERNATE(PE07_RC2_UART7_RX) | \
					 PIN_MODE_OUTPUT(PE08_DIS_E) | \
					 PIN_MODE_OUTPUT(PE09_DIS_D) | \
					 PIN_MODE_INPUT(PE10) | \
					 PIN_MODE_INPUT(PE11) | \
					 PIN_MODE_INPUT(PE12) | \
					 PIN_MODE_INPUT(PE13) | \
					 PIN_MODE_INPUT(PE14) | \
					 PIN_MODE_OUTPUT(PE15_XB_RST))

#define VAL_GPIOE_OTYPER                (PIN_OTYPE_PUSHPULL(PE00_UART8_RX) | \
					 PIN_OTYPE_PUSHPULL(PE01_UART8_TX) | \
					 PIN_OTYPE_PUSHPULL(PE02_DIS_G) | \
					 PIN_OTYPE_PUSHPULL(PE03_DIS_F) | \
					 PIN_OTYPE_PUSHPULL(PE04_DIS_A) | \
					 PIN_OTYPE_PUSHPULL(PE05_DIS_B) | \
					 PIN_OTYPE_PUSHPULL(PE06_APSW) | \
					 PIN_OTYPE_PUSHPULL(PE07_RC2_UART7_RX) | \
					 PIN_OTYPE_PUSHPULL(PE08_DIS_E) | \
					 PIN_OTYPE_PUSHPULL(PE09_DIS_D) | \
					 PIN_OTYPE_PUSHPULL(PE10) | \
					 PIN_OTYPE_PUSHPULL(PE11) | \
					 PIN_OTYPE_PUSHPULL(PE12) | \
					 PIN_OTYPE_PUSHPULL(PE13) | \
					 PIN_OTYPE_PUSHPULL(PE14) | \
					 PIN_OTYPE_PUSHPULL(PE15_XB_RST))

#define VAL_GPIOE_OSPEEDR               (PIN_OSPEED_SPEED_HIGH(PE00_UART8_RX) | \
					 PIN_OSPEED_SPEED_HIGH(PE01_UART8_TX) | \
					 PIN_OSPEED_SPEED_VERYLOW(PE02_DIS_G) | \
					 PIN_OSPEED_SPEED_VERYLOW(PE03_DIS_F) | \
					 PIN_OSPEED_SPEED_VERYLOW(PE04_DIS_A) | \
					 PIN_OSPEED_SPEED_VERYLOW(PE05_DIS_B) | \
					 PIN_OSPEED_SPEED_VERYLOW(PE06_APSW) | \
					 PIN_OSPEED_SPEED_HIGH(PE07_RC2_UART7_RX) | \
					 PIN_OSPEED_SPEED_VERYLOW(PE08_DIS_E) | \
					 PIN_OSPEED_SPEED_VERYLOW(PE09_DIS_D) | \
					 PIN_OSPEED_SPEED_VERYLOW(PE10) | \
					 PIN_OSPEED_SPEED_VERYLOW(PE11) | \
					 PIN_OSPEED_SPEED_VERYLOW(PE12) | \
					 PIN_OSPEED_SPEED_VERYLOW(PE13) | \
					 PIN_OSPEED_SPEED_VERYLOW(PE14) | \
					 PIN_OSPEED_SPEED_VERYLOW(PE15_XB_RST))

#define VAL_GPIOE_PUPDR                 (PIN_PUPDR_FLOATING(PE00_UART8_RX) | \
					 PIN_PUPDR_FLOATING(PE01_UART8_TX) | \
					 PIN_PUPDR_FLOATING(PE02_DIS_G) | \
					 PIN_PUPDR_FLOATING(PE03_DIS_F) | \
					 PIN_PUPDR_FLOATING(PE04_DIS_A) | \
					 PIN_PUPDR_FLOATING(PE05_DIS_B) | \
					 PIN_PUPDR_FLOATING(PE06_APSW) | \
					 PIN_PUPDR_FLOATING(PE07_RC2_UART7_RX) | \
					 PIN_PUPDR_FLOATING(PE08_DIS_E) | \
					 PIN_PUPDR_FLOATING(PE09_DIS_D) | \
					 PIN_PUPDR_PULLDOWN(PE10) | \
					 PIN_PUPDR_PULLDOWN(PE11) | \
					 PIN_PUPDR_PULLDOWN(PE12) | \
					 PIN_PUPDR_PULLDOWN(PE13) | \
					 PIN_PUPDR_PULLDOWN(PE14) | \
					 PIN_PUPDR_FLOATING(PE15_XB_RST))

#define VAL_GPIOE_ODR                   (PIN_ODR_LEVEL_HIGH(PE00_UART8_RX) | \
					 PIN_ODR_LEVEL_HIGH(PE01_UART8_TX) | \
					 PIN_ODR_LEVEL_LOW(PE02_DIS_G) | \
					 PIN_ODR_LEVEL_LOW(PE03_DIS_F) | \
					 PIN_ODR_LEVEL_LOW(PE04_DIS_A) | \
					 PIN_ODR_LEVEL_LOW(PE05_DIS_B) | \
					 PIN_ODR_LEVEL_HIGH(PE06_APSW) | \
					 PIN_ODR_LEVEL_HIGH(PE07_RC2_UART7_RX) | \
					 PIN_ODR_LEVEL_LOW(PE08_DIS_E) | \
					 PIN_ODR_LEVEL_LOW(PE09_DIS_D) | \
					 PIN_ODR_LEVEL_LOW(PE10) | \
					 PIN_ODR_LEVEL_LOW(PE11) | \
					 PIN_ODR_LEVEL_LOW(PE12) | \
					 PIN_ODR_LEVEL_LOW(PE13) | \
					 PIN_ODR_LEVEL_LOW(PE14) | \
					 PIN_ODR_LEVEL_HIGH(PE15_XB_RST))

#define VAL_GPIOE_AFRL			(PIN_AFIO_AF(PE00_UART8_RX, 8) | \
					 PIN_AFIO_AF(PE01_UART8_TX, 8) | \
					 PIN_AFIO_AF(PE02_DIS_G, 0) | \
					 PIN_AFIO_AF(PE03_DIS_F, 0) | \
					 PIN_AFIO_AF(PE04_DIS_A, 0) | \
					 PIN_AFIO_AF(PE05_DIS_B, 0) | \
					 PIN_AFIO_AF(PE06_APSW, 0) | \
					 PIN_AFIO_AF(PE07_RC2_UART7_RX, 8))

#define VAL_GPIOE_AFRH			(PIN_AFIO_AF(PE08_DIS_E, 0) | \
					 PIN_AFIO_AF(PE09_DIS_D, 0) | \
					 PIN_AFIO_AF(PE10, 0) | \
					 PIN_AFIO_AF(PE11, 0) | \
					 PIN_AFIO_AF(PE12, 0) | \
					 PIN_AFIO_AF(PE13, 0) | \
					 PIN_AFIO_AF(PE14, 0) | \
					 PIN_AFIO_AF(PE15_XB_RST, 0))

#define VAL_GPIOF_MODER                 (PIN_MODE_INPUT(PF00) | \
					 PIN_MODE_INPUT(PF01) | \
					 PIN_MODE_INPUT(PF02) | \
					 PIN_MODE_INPUT(PF03) | \
					 PIN_MODE_INPUT(PF04) | \
					 PIN_MODE_INPUT(PF05) | \
					 PIN_MODE_INPUT(PF06) | \
					 PIN_MODE_INPUT(PF07) | \
					 PIN_MODE_INPUT(PF08) | \
					 PIN_MODE_INPUT(PF09) | \
					 PIN_MODE_INPUT(PF10) | \
					 PIN_MODE_INPUT(PF11) | \
					 PIN_MODE_INPUT(PF12) | \
					 PIN_MODE_INPUT(PF13) | \
					 PIN_MODE_INPUT(PF14) | \
					 PIN_MODE_INPUT(PF15))

#define VAL_GPIOF_OTYPER                (PIN_OTYPE_PUSHPULL(PF00) | \
					 PIN_OTYPE_PUSHPULL(PF01) | \
					 PIN_OTYPE_PUSHPULL(PF02) | \
					 PIN_OTYPE_PUSHPULL(PF03) | \
					 PIN_OTYPE_PUSHPULL(PF04) | \
					 PIN_OTYPE_PUSHPULL(PF05) | \
					 PIN_OTYPE_PUSHPULL(PF06) | \
					 PIN_OTYPE_PUSHPULL(PF07) | \
					 PIN_OTYPE_PUSHPULL(PF08) | \
					 PIN_OTYPE_PUSHPULL(PF09) | \
					 PIN_OTYPE_PUSHPULL(PF10) | \
					 PIN_OTYPE_PUSHPULL(PF11) | \
					 PIN_OTYPE_PUSHPULL(PF12) | \
					 PIN_OTYPE_PUSHPULL(PF13) | \
					 PIN_OTYPE_PUSHPULL(PF14) | \
					 PIN_OTYPE_PUSHPULL(PF15))

#define VAL_GPIOF_OSPEEDR               (PIN_OSPEED_SPEED_VERYLOW(PF00) | \
					 PIN_OSPEED_SPEED_VERYLOW(PF01) | \
					 PIN_OSPEED_SPEED_VERYLOW(PF02) | \
					 PIN_OSPEED_SPEED_VERYLOW(PF03) | \
					 PIN_OSPEED_SPEED_VERYLOW(PF04) | \
					 PIN_OSPEED_SPEED_VERYLOW(PF05) | \
					 PIN_OSPEED_SPEED_VERYLOW(PF06) | \
					 PIN_OSPEED_SPEED_VERYLOW(PF07) | \
					 PIN_OSPEED_SPEED_VERYLOW(PF08) | \
					 PIN_OSPEED_SPEED_VERYLOW(PF09) | \
					 PIN_OSPEED_SPEED_VERYLOW(PF10) | \
					 PIN_OSPEED_SPEED_VERYLOW(PF11) | \
					 PIN_OSPEED_SPEED_VERYLOW(PF12) | \
					 PIN_OSPEED_SPEED_VERYLOW(PF13) | \
					 PIN_OSPEED_SPEED_VERYLOW(PF14) | \
					 PIN_OSPEED_SPEED_VERYLOW(PF15))

#define VAL_GPIOF_PUPDR                 (PIN_PUPDR_PULLDOWN(PF00) | \
					 PIN_PUPDR_PULLDOWN(PF01) | \
					 PIN_PUPDR_PULLDOWN(PF02) | \
					 PIN_PUPDR_PULLDOWN(PF03) | \
					 PIN_PUPDR_PULLDOWN(PF04) | \
					 PIN_PUPDR_PULLDOWN(PF05) | \
					 PIN_PUPDR_PULLDOWN(PF06) | \
					 PIN_PUPDR_PULLDOWN(PF07) | \
					 PIN_PUPDR_PULLDOWN(PF08) | \
					 PIN_PUPDR_PULLDOWN(PF09) | \
					 PIN_PUPDR_PULLDOWN(PF10) | \
					 PIN_PUPDR_PULLDOWN(PF11) | \
					 PIN_PUPDR_PULLDOWN(PF12) | \
					 PIN_PUPDR_PULLDOWN(PF13) | \
					 PIN_PUPDR_PULLDOWN(PF14) | \
					 PIN_PUPDR_PULLDOWN(PF15))

#define VAL_GPIOF_ODR                   (PIN_ODR_LEVEL_LOW(PF00) | \
					 PIN_ODR_LEVEL_LOW(PF01) | \
					 PIN_ODR_LEVEL_LOW(PF02) | \
					 PIN_ODR_LEVEL_LOW(PF03) | \
					 PIN_ODR_LEVEL_LOW(PF04) | \
					 PIN_ODR_LEVEL_LOW(PF05) | \
					 PIN_ODR_LEVEL_LOW(PF06) | \
					 PIN_ODR_LEVEL_LOW(PF07) | \
					 PIN_ODR_LEVEL_LOW(PF08) | \
					 PIN_ODR_LEVEL_LOW(PF09) | \
					 PIN_ODR_LEVEL_LOW(PF10) | \
					 PIN_ODR_LEVEL_LOW(PF11) | \
					 PIN_ODR_LEVEL_LOW(PF12) | \
					 PIN_ODR_LEVEL_LOW(PF13) | \
					 PIN_ODR_LEVEL_LOW(PF14) | \
					 PIN_ODR_LEVEL_LOW(PF15))

#define VAL_GPIOF_AFRL			(PIN_AFIO_AF(PF00, 0) | \
					 PIN_AFIO_AF(PF01, 0) | \
					 PIN_AFIO_AF(PF02, 0) | \
					 PIN_AFIO_AF(PF03, 0) | \
					 PIN_AFIO_AF(PF04, 0) | \
					 PIN_AFIO_AF(PF05, 0) | \
					 PIN_AFIO_AF(PF06, 0) | \
					 PIN_AFIO_AF(PF07, 0))

#define VAL_GPIOF_AFRH			(PIN_AFIO_AF(PF08, 0) | \
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
					 PIN_OTYPE_PUSHPULL(PK08) | \
					 PIN_OTYPE_PUSHPULL(PK09) | \
					 PIN_OTYPE_PUSHPULL(PK10) | \
					 PIN_OTYPE_PUSHPULL(PK11) | \
					 PIN_OTYPE_PUSHPULL(PK12) | \
					 PIN_OTYPE_PUSHPULL(PK13) | \
					 PIN_OTYPE_PUSHPULL(PK14) | \
					 PIN_OTYPE_PUSHPULL(PK15))

#define VAL_GPIOK_OSPEEDR               (PIN_OSPEED_SPEED_VERYLOW(PK00) | \
					 PIN_OSPEED_SPEED_VERYLOW(PK01) | \
					 PIN_OSPEED_SPEED_VERYLOW(PK02) | \
					 PIN_OSPEED_SPEED_VERYLOW(PK03) | \
					 PIN_OSPEED_SPEED_VERYLOW(PK04) | \
					 PIN_OSPEED_SPEED_VERYLOW(PK05) | \
					 PIN_OSPEED_SPEED_VERYLOW(PK06) | \
					 PIN_OSPEED_SPEED_VERYLOW(PK07) | \
					 PIN_OSPEED_SPEED_VERYLOW(PK08) | \
					 PIN_OSPEED_SPEED_VERYLOW(PK09) | \
					 PIN_OSPEED_SPEED_VERYLOW(PK10) | \
					 PIN_OSPEED_SPEED_VERYLOW(PK11) | \
					 PIN_OSPEED_SPEED_VERYLOW(PK12) | \
					 PIN_OSPEED_SPEED_VERYLOW(PK13) | \
					 PIN_OSPEED_SPEED_VERYLOW(PK14) | \
					 PIN_OSPEED_SPEED_VERYLOW(PK15))

#define VAL_GPIOK_PUPDR                 (PIN_PUPDR_PULLDOWN(PK00) | \
					 PIN_PUPDR_PULLDOWN(PK01) | \
					 PIN_PUPDR_PULLDOWN(PK02) | \
					 PIN_PUPDR_PULLDOWN(PK03) | \
					 PIN_PUPDR_PULLDOWN(PK04) | \
					 PIN_PUPDR_PULLDOWN(PK05) | \
					 PIN_PUPDR_PULLDOWN(PK06) | \
					 PIN_PUPDR_PULLDOWN(PK07) | \
					 PIN_PUPDR_PULLDOWN(PK08) | \
					 PIN_PUPDR_PULLDOWN(PK09) | \
					 PIN_PUPDR_PULLDOWN(PK10) | \
					 PIN_PUPDR_PULLDOWN(PK11) | \
					 PIN_PUPDR_PULLDOWN(PK12) | \
					 PIN_PUPDR_PULLDOWN(PK13) | \
					 PIN_PUPDR_PULLDOWN(PK14) | \
					 PIN_PUPDR_PULLDOWN(PK15))

#define VAL_GPIOK_ODR                   (PIN_ODR_LEVEL_LOW(PK00) | \
					 PIN_ODR_LEVEL_LOW(PK01) | \
					 PIN_ODR_LEVEL_LOW(PK02) | \
					 PIN_ODR_LEVEL_LOW(PK03) | \
					 PIN_ODR_LEVEL_LOW(PK04) | \
					 PIN_ODR_LEVEL_LOW(PK05) | \
					 PIN_ODR_LEVEL_LOW(PK06) | \
					 PIN_ODR_LEVEL_LOW(PK07) | \
					 PIN_ODR_LEVEL_LOW(PK08) | \
					 PIN_ODR_LEVEL_LOW(PK09) | \
					 PIN_ODR_LEVEL_LOW(PK10) | \
					 PIN_ODR_LEVEL_LOW(PK11) | \
					 PIN_ODR_LEVEL_LOW(PK12) | \
					 PIN_ODR_LEVEL_LOW(PK13) | \
					 PIN_ODR_LEVEL_LOW(PK14) | \
					 PIN_ODR_LEVEL_LOW(PK15))

#define VAL_GPIOK_AFRL			(PIN_AFIO_AF(PK00, 0) | \
					 PIN_AFIO_AF(PK01, 0) | \
					 PIN_AFIO_AF(PK02, 0) | \
					 PIN_AFIO_AF(PK03, 0) | \
					 PIN_AFIO_AF(PK04, 0) | \
					 PIN_AFIO_AF(PK05, 0) | \
					 PIN_AFIO_AF(PK06, 0) | \
					 PIN_AFIO_AF(PK07, 0))

#define VAL_GPIOK_AFRH			(PIN_AFIO_AF(PK08, 0) | \
					 PIN_AFIO_AF(PK09, 0) | \
					 PIN_AFIO_AF(PK10, 0) | \
					 PIN_AFIO_AF(PK11, 0) | \
					 PIN_AFIO_AF(PK12, 0) | \
					 PIN_AFIO_AF(PK13, 0) | \
					 PIN_AFIO_AF(PK14, 0) | \
					 PIN_AFIO_AF(PK15, 0))

#define AF_PA01_RC1_UART4_RX             8U
#define AF_LINE_RC1_UART4_RX             8U
#define AF_PA06_SRV0_TIM3_CH1            2U
#define AF_LINE_SRV0_TIM3_CH1            2U
#define AF_PA07_SRV1_TIM3_CH2            2U
#define AF_LINE_SRV1_TIM3_CH2            2U
#define AF_PA11_OTG_FS_DM                10U
#define AF_LINE_OTG_FS_DM                10U
#define AF_PA12_OTG_FS_DP                10U
#define AF_LINE_OTG_FS_DP                10U
#define AF_PA13_SWDIO                    0U
#define AF_LINE_SWDIO                    0U
#define AF_PA14_SWCLK                    0U
#define AF_LINE_SWCLK                    0U
#define AF_PB00_SRV2_TIM3_CH3            2U
#define AF_LINE_SRV2_TIM3_CH3            2U
#define AF_PB01_SRV3_TIM3_CH4            2U
#define AF_LINE_SRV3_TIM3_CH4            2U
#define AF_PB03_SPI1_SCK                 5U
#define AF_LINE_SPI1_SCK                 5U
#define AF_PB04_SPI1_MISO                5U
#define AF_LINE_SPI1_MISO                5U
#define AF_PB05_SPI1_MOSI                5U
#define AF_LINE_SPI1_MOSI                5U
#define AF_PB06_USART1_TX                7U
#define AF_LINE_USART1_TX                7U
#define AF_PB07_USART1_RX                7U
#define AF_LINE_USART1_RX                7U
#define AF_PB08_I2C1_SCL                 4U
#define AF_LINE_I2C1_SCL                 4U
#define AF_PB09_I2C1_SDA                 4U
#define AF_LINE_I2C1_SDA                 4U
#define AF_PB10_I2C2_SCL                 4U
#define AF_LINE_I2C2_SCL                 4U
#define AF_PB11_I2C2_SDA                 4U
#define AF_LINE_I2C2_SDA                 4U
#define AF_PC08_SDMMC1_D0                12U
#define AF_LINE_SDMMC1_D0                12U
#define AF_PC09_SDMMC1_D1                12U
#define AF_LINE_SDMMC1_D1                12U
#define AF_PC10_SDMMC1_D2                12U
#define AF_LINE_SDMMC1_D2                12U
#define AF_PC11_SDMMC1_D3                12U
#define AF_LINE_SDMMC1_D3                12U
#define AF_PC12_SDMMC1_CK                12U
#define AF_LINE_SDMMC1_CK                12U
#define AF_PD00_CAN1_RX                  9U
#define AF_LINE_CAN1_RX                  9U
#define AF_PD01_CAN1_TX                  9U
#define AF_LINE_CAN1_TX                  9U
#define AF_PD02_SDMMC1_CMD               12U
#define AF_LINE_SDMMC1_CMD               12U
#define AF_PD03_USART2_CTS               7U
#define AF_LINE_USART2_CTS               7U
#define AF_PD04_USART2_RTS               7U
#define AF_LINE_USART2_RTS               7U
#define AF_PD05_USART2_TX                7U
#define AF_LINE_USART2_TX                7U
#define AF_PD06_USART2_RX                7U
#define AF_LINE_USART2_RX                7U
#define AF_PD08_USART3_TX                7U
#define AF_LINE_USART3_TX                7U
#define AF_PD09_USART3_RX                7U
#define AF_LINE_USART3_RX                7U
#define AF_PD12_SRV4_TIM4_CH1            2U
#define AF_LINE_SRV4_TIM4_CH1            2U
#define AF_PD13_SRV5_TIM4_CH2            2U
#define AF_LINE_SRV5_TIM4_CH2            2U
#define AF_PD14_SRV6_TIM4_CH3            2U
#define AF_LINE_SRV6_TIM4_CH3            2U
#define AF_PD15_SRV7_TIM4_CH4            2U
#define AF_LINE_SRV7_TIM4_CH4            2U
#define AF_PE00_UART8_RX                 8U
#define AF_LINE_UART8_RX                 8U
#define AF_PE01_UART8_TX                 8U
#define AF_LINE_UART8_TX                 8U
#define AF_PE07_RC2_UART7_RX             8U
#define AF_LINE_RC2_UART7_RX             8U



#define BOARD_GROUP_DECLFOREACH(line, group) \
  static const ioline_t group ## _ARRAY[] = {group}; \
  for (ioline_t i=0, line =  group ## _ARRAY[i]; (i < group ## _SIZE) && (line = group ## _ARRAY[i]); i++)

#define BOARD_GROUP_FOREACH(line, group) \
  for (ioline_t i=0, line =  group ## _ARRAY[i]; (i < group ## _SIZE) && (line = group ## _ARRAY[i]); i++)


#define BOARD_GROUP_DECLFOR(array, index, group)  \
  static const ioline_t group ## _ARRAY[] = {group};    \
  for (ioline_t index=0, *array =  (ioline_t *) group ## _ARRAY; index < group ## _SIZE; index++)

#define BOARD_GROUP_FOR(array, index, group)  \
  for (ioline_t index=0, *array =  (ioline_t *) group ## _ARRAY; index < group ## _SIZE; index++)

#if !defined(_FROM_ASM_)
#ifdef __cplusplus
extern "C" {
#endif
  void boardInit(void);
#ifdef __cplusplus
}
#endif
#endif /* _FROM_ASM_ */
