enacuavlab/boards/Tawaki/tawaki_chibios/source/main.c

#include <ch.h>
#include <hal.h>
#include <stdnoreturn.h>
#include "stdutil.h"
#include "ttyConsole.h"
#include "printf.h"

static THD_WORKING_AREA(waBlinker, 512);
static noreturn void blinker(void *arg);

int main(void)
{
  /*
 * System initializations.
 * - HAL initialization, this also initializes the configured device drivers
 *   and performs the board-specific initializations.
 * - Kernel initialization, the main() function becomes a thread and the
 *   RTOS is active.
 */

  halInit();
  chSysInit();
  initHeap();
  sdInit();

  chThdCreateStatic(waBlinker, sizeof(waBlinker), NORMALPRIO, &blinker, NULL);

  consoleInit();
  consoleLaunch();
  chThdSleep(TIME_INFINITE);
}

/*
#                 _      _                                 _                 
#                | |    | |                               | |                
#                | |_   | |__    _ __    ___    __ _    __| |   ___          
#                | __|  | '_ \  | '__|  / _ \  / _` |  / _` |  / __|         
#                \ |_   | | | | | |    |  __/ | (_| | | (_| |  \__ \         
#                 \__|  |_| |_| |_|     \___|  \__,_|  \__,_|  |___/         
*/
static noreturn void blinker(void *arg)
{
  (void)arg;
  chRegSetThreadName("blinker");
  while (true)
  {
    palToggleLine(LINE_D15_LED1);
    chThdSleepMilliseconds(500);
  }
}
