enacuavlab/boards/(commit log)

2021-02-25 Add Tawaki hardware and ChibiOS example.
    [Tawaki_v110.kicad_pcb, Tawaki_v110.sch, Tawaki_v110_BoM.ods, board.cfg, gabarit_soudage_molex_v0.DXF, gabarit_soudage_molex_v0.SLDPRT, test_ gabarit.SLDASM]
2022-04-29 Add Chimera example.
    [board.cfg]
