enacuavlab/boards/(notices)

Notices in the files:
Tawaki/hardware/Tawaki_v110.kicad_pcb:
PaPaRaZzi GPL
Tawaki/hardware/Tawaki_v110.sch:
Paparazzi GPL Project
